ditschi/looping_louie/docs/main-board-c6.md

# Main board with ESP32-C6: module, pinout, motor driver, layer stack, routing

Status: 2026-11-11 · Describes the current state of the main board (board A, `hardware/main-board/`): **rev B**
(low-Iq LDO TPS7A2633 for 3.3 V), the design to order. Rev A with the SPX3819 LDO is kept as a fallback under the
Git tag `rev-a-spx3819`.
Current decisions: **ESP32-C6-MINI-1**, motor driver **DRV8213DSG**, **USB-C J4** on the board (flashing
only via J4), **LDO TPS7A2633** for 3.3 V, **4 layers**, machine-assembled on one side only (bottom side only pads, test points and DNP footprints).
Rejected variants (C3, DRV8833, 2 layers, earlier USB variants, SPX3819, buck TPS62162): [decision-history.md](decision-history.md).
Background: [analysis-wireless-controllers.md](analysis-wireless-controllers.md) 3b, [hardware-concept.md](hardware-concept.md),
[idea-usb-c-main-board.md](idea-usb-c-main-board.md). Firmware: [firmware-architecture.md](firmware-architecture.md).

Markers: **(verified)** = source read or recalculated against the project files · **(uncertain)** = secondary source,
estimate, or not checked in the datasheet.

## Summary

- **Module:** ESP32-C6-MINI-1, target **-H8 (8 MB)**, fallback **-N4 (4 MB)**. Both are pin- and footprint-compatible,
  so the choice is made only when ordering. Since 2026-11-06 the H8 is also in stock at JLC (620 pcs).
- **Footprint:** custom `lcsc:WIFIM-SMD_ESP32-C6-MINI-1`. Do **not** use the KiCad footprint `RF_Module:ESP32-C6-MINI-1`:
  its courtyard contains a 43 × 20 mm antenna keepout zone (breaks `antenna_keepout()`), and a
  3D model is missing.
- **Motor driver:** **DRV8213DSG** (WSON-8 2 × 2 mm) with current sensing (IPROPI), current limiting (2 A) and autosleep.
  No shunt, no nSLEEP/nFAULT, only 2 GPIOs.
- **Lever:** "lever closed" = HIGH (R3 to GND, R4 to 3V3); the lever wakes the chip with ANY_HIGH on IO3.
- **USB-C J4** with ESD (flow-through), CC resistors and power path (D2 for VBUS, Q1 for BAT_IN).
- **Supply:** VSYS 3.0–6.6 V: 1S Li-ion, USB, 3 × or 4 × AA; LDO **TPS7A2633** (U3, WSON-6): board standby approx.
  15–18 µA over the whole range, 0.47 W loss at 6.4 V / 150 mA (4 fresh alkaline cells), cut-off at 3.4–3.5 V filtered.
  No 9 V block. All supply numbers: 2.7.
- **Zigbee:** the hardware needs **nothing extra**. A coordinator alongside the device's own hotspot or alongside
  a BLE scan is **not supported (X)** by Espressif; Zigbee is only realistic on the home Wi-Fi.
- **Layers:** 4 layers (JLC04081H-3313), In1 solid GND, rules 0.15/0.15 mm, via 0.3/0.5 mm (chapter 11).
- **Routing:** complete with the own router: ERC 0, DRC 0 errors and 0 warnings, 0 unconnected, 0 GND islands,
  149 vias (rev B, 11.4).
- **Optional pads on the bottom:** player inputs J6, LED connector J7, test points, DNP footprints (11.7).

---

## 1. Module and flash

| Candidate | Dimensions (mm) | Flash | Antenna | Availability / price (2026-11-02) | Assessment |
|---|---|---|---|---|---|
| **ESP32-C6-MINI-1-N4** (C5736265) | 13.2 × 16.6 × 2.4 | 4 MB | PCB | LCSC 1,380, JLC 3,921 pcs; 4.14 / 3.63 USD (1/10) (verified) | **Fallback**, can be assembled right away |
| ESP32-C6-MINI-1-H4 (C6553337) | same | 4 MB, 105 °C | PCB | JLC 534; 4.48 / 3.84 (verified) | no advantage |
| **ESP32-C6-MINI-1-H8** (C42403058) | same | **8 MB**, 105 °C | PCB | **JLC 620 pcs** (verified, JLC parts API 2026-11-06; still 0 on 2026-11-02); LCSC 11.67 (1), 4.66 (200+) (verified). **Mouser approx. €4.70, approx. 6,000 pcs** (uncertain, search hit) | **Target**, can be assembled directly at JLC |
| ESP32-C6-MINI-1U-H4 (C20627095) | 13.2 × 12.5 | 4 MB | U.FL | JLC 3,938; 4.20 (verified) | antenna plan B only; a 1U-H8 is not listed at LCSC |

Other C6 modules do not fit the AA format or have only 4 MB with a PCB antenna; a chip-down design (C6FH8 + custom
antenna) is not worth it (decision-history.md).

**Decision:** plan for the **ESP32-C6-MINI-1-H8**. If JLC has no H8 at the time of ordering, the **N4** is assembled
without any layout change.

**Why 8 MB:** real OTA needs two app partitions; on top of that come the web UI, modes and possibly Zigbee. With 8 MB,
e.g. 2 × 3 MiB app plus approx. 1.9 MiB data fit. With 4 MB (N4), OTA gets tight; how large the Rust firmware (std on
ESP-IDF) will be has not been measured yet (uncertain). Partitioning: [firmware-architecture.md](firmware-architecture.md).

---

## 2. Module on the board

### 2.1 Footprint (verified)

Footprint `lcsc:WIFIM-SMD_ESP32-C6-MINI-1` (generated by `fetch_parts.py`): 53 pads on a 0.8 mm grid (0.8 × 0.4 mm),
pad 49 made of 9 sub-areas, courtyard 13.2 × 16.6 mm, 3D model of the C6. The pads are taken from the pad-identical
lcsc footprint of the ESP32-C3-MINI-1, because the EasyEDA footprint of the C6 is off the grid by up to 20 µm. GND pads 1, 2, 11, 14, 36–53;
3V3 = 3, EN = 8; NC = 4, 7, 21, 32–35. Antenna at the −y end of the footprint → board −x.

The KiCad footprint `RF_Module:ESP32-C6-MINI-1` is pad-identical (pad 49 shifted by max. 5 µm), but has a courtyard
of 13.5 × 16.9 mm **plus a keepout zone of 43.2 × 20.4 mm** (unusable for `antenna_keepout()`) and in KiCad 9 no
3D model.

### 2.2 Pad positions on the board

Module at x = −8.8, rotation 90°, antenna at −x (read from `louie-main.kicad_pcb`, verified):

| Module side | Pads (order) | Position | Neighbours |
|---|---|---|---|
| **right** (x = −3.9), y +4.8 → −4.8 | 12 IO0, 13 IO1, 14 GND, 15 IO6, 16 IO7, **17 IO12**, **18 IO13**, 19 IO14, 20 IO15, 21 NC, 22 IO8, 23 IO9, 24 IO18 | towards the driver and USB-C | 0402 row x = −1.9 |
| **edge +y** (y = +5.9), x −12.8 → −4.8 | 1/2 GND, 3 3V3, 4 NC, 5 IO2, 6 IO3, 7 NC, 8 EN, 9 IO4, 10 IO5, 11 GND | ISEN side | R5 (SENSE) |
| **edge −y** (y = −5.9), x −4.8 → −12.8 | 25 IO19, 26 IO20, 27 IO21, 28 IO22, 29 IO23, 30 RXD/IO17, 31 TXD/IO16, 32–35 NC | VSYS band, C1/C2, LDO | J3 on the bottom |

**All ADC pins (IO0–IO6) are in the +y half.** USB (IO12/13) sits in the middle of the right side and thus points
directly at the USB-C receptacle J4 (x ≈ 10.5–20.1, pads at y ≈ −1.6). For this, **a channel at y ≈ −0.5 … +1.2 stays free**; the
small DRV8213 (chapter 3) sits at the −y corner of the module.

### 2.3 Pinout (authoritative)

| GPIO (pad) | Net | Function | Rationale |
|---|---|---|---|
| IO0 (12) | VBAT_ADC | divider 680k/470k | ADC1_CH0; C6 measures up to 3.3 V → 6.6 V gives 2.7 V (2.7) |
| IO1 (13) | ISEN_ADC | IPROPI via RC | ADC1_CH1, +y side like the driver tap |
| IO2 (5) | INT | INT pad J2 (sensor INT1 or vibration switch) | LP GPIO → deep-sleep wake-up, no strapping |
| IO3 (6) | SENSE | lever, deep-sleep wake-up | LP GPIO, unchanged |
| IO4 (9) | VBUS_DET | VBUS divider (new) | ADC1_CH4 + LP wake-up on plug-in; strapping only SDIO edge |
| IO5 (10) | IO5 | S1 player input (J6-2) | ADC/deep-sleep wake-up |
| IO6 (15) | SDA | I²C (LIS2DH12, J2) | LP I²C (usable by the LP core) |
| IO7 (16) | SCL | I²C (J2) | LP I²C |
| IO8 (22) | IO8 | strapping, **10 k pull-up**; S4 player input (J6-5) | must be 1 during download, irrelevant for SPI boot (11.7) |
| IO9 (23) | BOOT | J3, button to GND | internal pull-up |
| IO12 (17) | USB_D− | J4 A7/B7 via ESD U5 (pin 3 → 4) | fixed in the chip |
| IO13 (18) | USB_D+ | J4 A6/B6 via ESD U5 (pin 1 → 6) | fixed in the chip |
| IO14 (19) | LED | status LED via 1 k | below the USB channel |
| IO15 (20) | IO15 | enable of LED LDO U6 (VLED on J7), R22 100 k to GND | strapping JTAG source, no effect without eFuse; no internal pull |
| IO18 (24) | MOT_IN1 | DRV8213 IN1 (LEDC PWM) | module corner bottom right, close to driver and VSYS band |
| IO19 (25) | MOT_IN2 | DRV8213 IN2 (LEDC PWM) | same |
| IO20 / IO21 (26/27) | IO20 / IO21 | S2 / S3 player inputs (J6-3/-4) | internal pull-up |
| IO22 / IO23 (28/29) | – / IO23 | IO22 free (reserve) / LED data J7-2 | keeping the power bank awake is done in firmware (idea-power-bank.md) |
| IO17 RXD (30) | RXD | console, J3-5 | |
| IO16 TXD (31) | TXD | J3, console | ROM log |

**Except for IO22 (reserve), all GPIOs are used**; IO5, IO8, IO15, IO17, IO20, IO21 and IO23 go to optional
pads and unpopulated footprints on the bottom (11.7, idea-optional-hardware.md 0b).

### 2.4 Strapping, USB, reset

- **IO8:** 10 k to 3V3 (R11). **IO9:** internal pull-up is sufficient, pad J3. **IO15:** strapping has no effect
  without eFuse, R22 (DNP) to GND. **IO4/IO5:** level during boot irrelevant (SDIO timing). **IO2** is not a
  strapping pin on the C6; R10 is the SCL pull-up (verified, analysis-wireless-controllers.md 3b.1).
- **USB:** IO12 = D−, IO13 = D+. ESD (U5) directly at J4 and **flow-through**: J4 → U5 pin 1/3 → under the
  package → pin 6/4 → module. D+/D− cross at J4 (order B7 A6 A7 B6). No stub to J1: **flashing only via
  J4**; J1-2/3 have no net.
- **ESD finding (verified, ST DS4260 Rev 5):** on the USBLC6-2SC6, pins 1/6 (I/O1) and 3/4 (I/O2) are connected internally.
  ST shows a branch to the ESD as "Unsuitable layout" (Fig. 7) and flow-through as "Optimized layout"
  (Fig. 18): D+in pin 1 → D+out pin 6, D−in pin 3 → D−out pin 4. Every stub adds L·di/dt to the
  clamping voltage (approx. 6 nH at 10 mm → +144 V at 8 kV). VBUS on pin 5, GND on pin 2; the 100 nF capacitor on VBUS
  recommended by ST is not fitted (D2 and the 47 µF buffers sit behind it). Second source UMW C2687116,
  same pinout.
- **EN:** R2 10 k / C12 1 µF. On the C6, download works automatically via USB-Serial-JTAG; BOOT remains on the
  pad as a fallback.

### 2.5 Wake-up via SENSE

**Circuit: R3 100 k OUT_A → GND, R4 10 k OUT_B → 3V3, R5 470 k SENSE → IO3.** "Lever closed" = HIGH.
R5 is only a series resistor into the high-impedance input (it does not change the levels below); 470 k limits the
current into the IO3 clamp diodes while OUT_A switches up to VSYS (6.6 V: approx. 6 µA; with 100 k it was 30 µA) and keeps
the level error from input leakage small (approx. 50 nA × 470 k ≈ 25 mV).

| State | SENSE | Wake-up |
|---|---|---|
| Lever open | 0 V (via 100 k) | – |
| Lever closed | 3.3 V × 100/110 ≈ **3.0 V** | ext1 wake-up ANY_HIGH on IO3 |
| Motor running | not meaningful, current via IPROPI | – |

Quiescent current with the lever closed approx. 30 µA. At VM = 5.5 V, OUT_B feeds approx. 0.2 mA back into the 3V3 rail;
the load absorbs this (not critical). **Special case:** if the lever stays closed when going to sleep, the firmware must
wake on LOW or check via timer (e.g. every 5 s). Check this case in the test setup ([test-hardware.md](test-hardware.md) 4.2).
Why not the inverse level: decision-history.md.

### 2.6 Antenna (finding L2 from analysis-wireless-controllers.md)

`antenna_keepout()`: rule areas "Antenna", "Antenna edge" and "Antenna end" **on all four layers**, with
copper fill and vias prohibited, **tracks allowed**. There is no GND under the antenna; the OUT_A track to BT1
runs on the bottom in the edge strip. The edge strip is at the **−y** edge (OUT_A runs from the DRV8213 at the
−y module corner to BT1 without crossing; electrically equivalent to +y, uncertain → RSSI test in both mounting orientations)
(analysis-wireless-controllers.md 2.3).

---

### 2.7 Supply

**This section is the single reference for the supply numbers** (VSYS range, 3.3 V regulator, dissipation, standby,
cut-off thresholds, divider); other documents link here instead of repeating them. Decisions: VSYS 3.0–6.6 V
(2026-11-09, F18) and **low-Iq LDO TPS7A2633 for 3.3 V (2026-11-11, rev B = the design to order)**, so that a 1S Li-ion
cell keeps a low standby current over its whole range. The buck TPS62162 tried earlier the same day did not enter
power-save mode below about 3.8 V input (finding W21). Rev A with the LDO SPX3819 in SOT-23-5 is kept as a fallback under
the Git tag `rev-a-spx3819`. Reasons and rejected options: [decision-history.md](decision-history.md); comparison and sources:
[proposal-supply-standby.md](proposal-supply-standby.md).

Sources on VSYS: protected 1S Li-ion cell on J5/J1 (3.0–4.2 V), USB via D2 (approx. 4.6 V), **3 × or 4 × AA**
(alkaline up to 6.4–6.6 V fresh, NiMH up to approx. 5.6 V) on BAT_IN. The motor voltage follows the profile of the game
(`duty = U_target / U_battery`, hardware-concept.md 4); for games with 4 × AA the motor reaches its usual voltage only
with 4 cells on BAT_IN.

Markers in this section: **(verified)** = TI SBVS290B (TPS7A26) or the JLC parts API (2026-11-11), datasheet delta
review in [wiring-review.md](wiring-review.md) 9 · **(unverified)** = estimate, the prototype decides (tests in
[test-hardware.md](test-hardware.md) 4.7).

| Item | Value | Note |
|---|---|---|
| VSYS range | **3.0–6.6 V** continuous, 7 V transient (4 fresh alkaline cells, unloaded) | 9 V block and 2S Li-ion are not supported (below) |
| 3.3 V regulator U3 | **TPS7A2633DRVR** (TI), LDO, 3.3 V fixed (±1 %), 500 mA, VIN 2.4–18 V (20 V abs. max), current limit 525–970 mA, thermal shutdown 165 °C, WSON-6 2 × 2 mm with exposed pad (DRV), LCSC C2876256 | (verified). Second source: TPS7A2601 (adjustable) C2859671 with a divider |
| C8 / C9 / C10 | C8 **4.7 µF 16 V 0402** at IN (TI: ≥ 1 µF) · C9 **22 µF 10 V 0805** at OUT (TI: 1–100 µF) · C10 100 nF 0402 at the module side; L1 and C11 not fitted | (unverified: effective C8 at 6.6 V under DC bias, no part number yet) |
| U3 pin wiring | EN (4) tied to IN (6) through the VSYS edge track, OUT (1) to C9, NC (2) and PG (3) to GND (TI: better thermal performance), GND (5) and the exposed pad (7) to GND with two tented thermal vias | (verified against SBVS290B, wiring-review.md 9) |
| Dissipation of U3, 150 mA average (hotspot mode) | (VSYS − 3.3 V) × I: **0.47 W at 6.4 V** (4 fresh alkaline cells), 0.30 W at 5.3 V (4 × AA mid-life, NiMH), 0.06–0.14 W with Li-ion | θJA 73.3 K/W (JEDEC board): about +34 / +22 / +4…+10 K; on this small board possibly more (unverified; test T14) |
| Standby, board total in deep sleep | **approx. 15–18 µA over the whole range**: U3 2 µA typ / 4.5 µA max at no load (11–15 µA at 1 mA load, so a few µA at the deep-sleep load) + ESP32-C6 about 7 µA + VBAT divider 3–6 µA + LIS2DH12 about 2 µA + leakage; 1000 mAh Li-ion: years, limited by self-discharge | (unverified; test T13 at 3.5 / 3.7 / 4.0 / 6.0 V). IQ in dropout is not specified |
| Low end (dropout) | dropout 173 / 280 mV (typ / max) at 250 mA, 355 / 590 mV at 500 mA → **about 0.27 V typ, 0.45 V max at the 380 mA radio peak**; 3V3 ≥ 3.0 V down to about VSYS 3.3–3.45 V; below that 3V3 follows VSYS | (verified table, interpolated; test T12) |
| Efficiency | 3.3 V / VSYS: about 89 % with Li-ion (as a buck), about 62 % at 5.3 V; with 4 × AA the play time drops by perhaps 10 %, because the motor draws most of the battery current | (unverified; motor current not measured, A2) |
| UVLO of U3 | 2.09 V falling / 2.15 V rising typ: below VSYS ≈ 3.3 V the output simply follows the input; the C6 brownout reset is the floor | (verified) |
| Cut-off thresholds (review R-B2) | evaluate **filtered, low-load** VSYS only (e.g. median over 2 s while duty ≤ 20 %), never during the first 300 ms of a ramp or during a stall. **Warn below 3.6 V; end the round at the next pause below 3.5 V** (3.4 V if T12 shows the typical dropout). Firmware placeholder `VSYS_MIN_MV = 3500` (`firmware/louie-fw/src/main.rs`). Brownout reset of the C6 as the last resort | final numbers from the sag measurement (test-hardware.md 4.1) and T12 |
| VBAT divider R6/R7, C13 | **680 k / 470 k** (ratio 2.447), 100 nF; 6.6 V → 2.7 V at the ADC, 3.0 V → 1.23 V; 3–6 µA | ADC check test-hardware.md 4.5 |

| Part on VSYS | Choice | Why |
|---|---|---|
| C1/C2 | **47 µF 16 V 1206** | margin and less DC-bias loss at 6.6 V |
| U6 (DNP, LED option J7) | **SPX3819M5-L (adjustable) at 3.95 V** (R23/R24 220 k / 100 k, C18 2.2 µF at the output) instead of load switch TPS22918 | enable on IO15 (R22 keeps it off) switches off the quiescent current of the LEDs; limits VLED. At 3.95 V the V5 LED types need V_IH 0.63 · 3.95 = 2.49 V, below the guaranteed ESP32 V_OH of 2.64 V (at 5.0 V they would need 3.15 V and a level shifter, for which there is no room on the bottom). With a Li-ion cell it runs in dropout (VLED ≈ VSYS − 0.3 V). Keep the brightness cap (approx. 30 %) so the LDO stays below approx. 0.3 W |
| F1 | **dropped** (VLED directly from U6) | U6 limits at approx. 0.8–0.95 A and has thermal shutdown; a 0.5 A PTC would hardly trip |
| JP1 | **dropped** | a bypass would put up to 6.6 V on the LEDs |
| U2 DRV8213, Q1 AO3401A, D2 SS34F | unchanged | VM up to 11 V; 30 V / VGS ±12 V; 40 V. **USB + 4 × AA:** Q1 only blocks while the battery is below VBUS. Above approx. 5.2 V the cells feed through its body diode even with USB plugged in; at a 2 A stall Q1 would dissipate up to approx. 1.6 W. Decision: no hardware change; use USB without AA cells, and the firmware lowers the stall limit to 0.8 A when VBUS is present and VSYS > 5.2 V (approx. 0.6 W for at most 300 ms). A real power mux is open item F28 |

**Layout of the LDO block (rev B, generated by `gen_main_pcb.preroute_ldo()`, nothing in the GUI):**
- Block at the +y edge on top: U3 (2.4, 4.97, 270°) with EN (x 1.75), GND (2.4) and IN (3.05) towards the edge at
  y 5.86 and PG, NC and OUT (x 1.75 / 2.4 / 3.05) towards the board centre at y 4.08. C8 (4.22, 5.6, 90°) right of IN,
  C9 (2.6, 2.45, 180°) right under OUT, 0.55 mm above the USB pair in the channel (y 1.13). Q1 (7.6, 4.95), R6/R7 at
  x −0.46, J2 unchanged (3.4, 4.3).
- VSYS comes from the vias of `preroute_battery_vsys()` at (5.5, 5.9) and (5.5, 6.47) over a **0.3 mm edge track at
  y 6.5** that runs west past C8 pad 1, IN and EN (0.2 mm stubs) into R6 pad 1 (VBAT divider). EN is tied to IN through
  this track. The bottom path of the battery current jogs back to x 4.67 between J2 pads 3 and 4.
- OUT goes 0.3 mm straight into C9 pad 1; C8 pad 2 runs on F.Cu into the exposed pad, GND/NC/PG stubs into the
  exposed pad. **Two** thermal vias at (2.13, 4.70) and (2.13, 5.25), centred in the gap between J2 pads 2 and 3 on the
  bottom; the board tents vias on both sides.
- 3V3 trunk to the module side, locked: via at (2.675, 3.375) next to the OUT track, 0.3 mm on In2 west under C9 to a
  via at (−1.775, 2.525), 0.3 mm on B.Cu into J2 pad 1; from there the router runs along the +y edge to module pad 3.
  Without it the router took a 40 mm detour (0.36 Ω); with it 48 mΩ (11.4). The rest of 3V3 (C10, pull-ups) is left to
  the router. The pre-routes are part of the routing baseline (11.4).

**Not supported:** 9 V block or 2S Li-ion. The TPS7A26 would accept 18 V, but at 9 V it would dissipate 0.85 W at
150 mA; the VBAT divider, the DRV8213 (11 V max), the R4 back-feed and a 2S charger would need a review, and the snap
terminals do not fit next to the board in a 9 V shell. The charger board is for 1S Li-ion only and must not be
connected to AA packs. Values marked "to check" in hardware/bom/parts.csv (U3 land pattern, C8 part number, LCSC number
of the adjustable SPX3819 for U6, availability of 47 µF 16 V) are listed in the delta review
([wiring-review.md](wiring-review.md) 9).

## 3. Motor control

**Decision: DRV8213DSGR (C22407186), GAINSEL to GND, R_IPROPI (R1) 1.24 k (1 %) to GND, followed by R8 1 k /
C14 100 nF to the ADC (IO1).** Do not put the capacitor directly on IPROPI, it would delay the current regulation.
Rationale: current sensing, current limiting and autosleep are built in; this saves a shunt, nSLEEP/nFAULT, 2 GPIOs and
approx. 30 mm² compared with a driver in HTSSOP-16. Rejected drivers (DRV8833, DRV8212, DRV8837): decision-history.md.

### 3.1 DRV8213DSG data

| Parameter | Value |
|---|---|
| VM | **1.65–11 V** (verified) |
| Rds(on) HS+LS | 240 mΩ typ. (GAINSEL = Low) (verified) |
| Current | 4 A peak, OCP approx. 4 A, RθJA 65.9 K/W (verified) |
| Current sensing | **IPROPI** 205 µA/A, ±6 % from 350 mA (verified) |
| Current limit | **ITRIP = 0.51 V / (R_IPROPI × 205 µA/A)**, R = 1.24 k → 2 A (verified) |
| Sleep | **Autosleep** after 1 ms with IN1 = IN2 = 0, < 60 nA (verified) |
| Faults | auto-retry (OCP, TSD), no pin (DSG) |
| Braking / reverse | yes: 1/1 = brake, 0/0 = coast (Hi-Z) (verified) |
| Package | WSON-8 2 × 2 mm with EP, courtyard approx. 7 mm² |
| Parts in the block | U2, R1 (R_IPROPI), C4, R8, C14 |
| GPIOs | **2** (IN1 = IO18, IN2 = IO19) |
| Price 10 pcs (JLC) | **0.93 USD** (C22407186, 3,749 pcs, Extended, 2026-11-02) |

### 3.2 Design

- Runs from 3.0 V battery up to 5.5 V USB, brakes, reverses and is high-impedance in coast/autosleep (needed for
  lever detection; whether no output pull-down is active in sleep is uncertain → check on the prototype board).
  Current limit 2 A.
- **Stall detection:** IPROPI measures while driving **and** during the brake phase. Therefore PWM as **drive/brake**:
  forward IN1 = 1, IN2 = PWM with duty cycle (1 − d). This gives 255 mV/A at the ADC. Hardware stall detection
  exists only in the RTE package; the firmware evaluates current > threshold over a time x.
- **Heat:** 1 A → 0.24 W → +16 K; 2 A continuous (stalled) → approx. 1 W → +63 K (verified, calculated with RθJA). The
  firmware must switch off a stall after ≤ 0.5 s. 2 thermal vias (0.3 mm) in the EP.
- **PWM:** LEDC at 20 kHz with approx. 11-bit resolution is sufficient; MCPWM is not needed.
- **Inputs:** IN1/IN2 have internal 200 k pull-downs in the DRV8213. **During** reset, the internal ~45 k pull-ups
  of IO18/IO19 pull both inputs HIGH → brake (no drive, no start-up possible); after reset both are 0
  (coast) (verified, C6 datasheet Tab. 2-1/2-2). Decision open (F17): leave as is, or add external 3.3 k pull-downs for
  coast during reset as well. Measurement in reset, boot and deep sleep: [test-hardware.md](test-hardware.md) 4.4.
- The DRV8213 and motor operation are only tested on the prototype board; on the breadboard there is no
  motor driver, only pre-order checks (motor current on the lab power supply, lever network, levels) and LED mode
  ([test-hardware.md](test-hardware.md) 4, 5).

---

## 4. Preparing for Zigbee

| Question | Finding | Status |
|---|---|---|
| Extra hardware? | **No.** 802.15.4 uses the same radio and the same RF path, i.e. also the module antenna | (verified) [C6 coexistence] |
| Zigbee + Wi-Fi SoftAP | Router/**Coordinator: X** (not supported), End Device: C1 | (verified) |
| Zigbee + Wi-Fi STA | Router/Coordinator: C1, End Device: Y | (verified) |
| Zigbee + BLE scan | Router/Coordinator: **X**, End Device: C1 | (verified) |
| Espressif recommendation for a gateway | Two chips with separate antennas (e.g. S3 + H2) | (verified) |
| Roles | IKEA/Aqara buttons are end devices and need a network with a **coordinator** (trust center). If Louie itself is an end device, it can only join an existing network (ZHA/Zigbee2MQTT), and the buttons are bound to it there | (uncertain, procedure) |
| Stack | `esp-zigbee-sdk`, precompiled libraries, ESP-IDF 5.5.x, C API | (verified) |
| Rust firmware | Since the firmware runs on ESP-IDF (std, esp-idf-sys), the SDK can be included as an ESP-IDF component and called via FFI | (uncertain, not tried) |
| Flash/RAM | Roughly +0.5–0.8 MB app, 50–100 KB RAM for a small coordinator. 8 MB is recommended for OTA | (uncertain) |
| Thread/Matter | same coexistence limits (Thread router + SoftAP = X). Matter over Wi-Fi needs no 802.15.4 | (verified / uncertain) |

**Assessment:** with the device's own hotspot (party mode, 8 phones), a Zigbee coordinator is **ruled out**, and
likewise alongside the BLE BTHome buttons. The only practical option would be "Louie on the home Wi-Fi (STA) + Zigbee". There, however,
it is simpler to connect the buttons via Home Assistant over Wi-Fi. **What is provided:** C6, **8 MB flash (H8)**, the
antenna keepout areas (2.6) and a good mounting location. Zigbee is **no reason for additional parts**
(operation: [idea-zigbee-operation.md](idea-zigbee-operation.md)).

---

## 5. Priority board A, optional board B

Requirement: **A works fully on its own** (second compartment = copper bridge or charger board).

### 5.1 Contents of A

| Block | Status | Remark |
|---|---|---|
| ESP32-C6-MINI-1 + C10, R2, C12 | **Must** | – |
| Motor driver DRV8213 + R1, C4, R8, C14 | **Must** | current sensing via IPROPI (chapter 3) |
| LDO TPS7A2633 (U3) + C8, C9 | **Must** | 3.3 V from VSYS 3.0–6.6 V, IQ 2 µA (2.7); second source TPS7A2601 (adjustable) with a divider |
| SENSE (R3, R4, R5) | **Must** | levels 2.5 |
| VBAT divider (R6, R7, C13) | **Must** (undervoltage, duty = U_target/U_battery) | – |
| USB-C J4, ESD U5, CC R12/R13, D2, Q1, R14/R15 | **Must** | ESD second source UMW; R14/R15 = VBUS_DET divider and gate pull-down of Q1 |
| Buffers C1, C2 (47 µF) | **Must** | – |
| Status LED D1/R9 | useful (diagnostics without a phone) | – |
| BOOT/EN/TXD/RXD | **pads only** (J3, bottom) | no button on top |
| I²C pull-ups R10/R16, IO8 pull-up R11 | on A (breakouts without pull-ups, IO8 strapping) | – |
| LIS2DH12 + C15 | top, **assembly optional** (DNP possible) | INT1 to IO2; SA0 on 3V3 → I²C address 0x19 (on GND the internal SA0 pull-up would draw approx. 150 µA); pads J2 in parallel |
| Optional pads/DNP on the bottom | J6, J7, TP1/TP2; DNP: U6 (LED LDO), R23, R24, C18, C17, R19, R20, C16, R22 | 11.7, 2.7 |

### 5.2 Interfaces (bottom side of A)

| Pad | Net | Purpose |
|---|---|---|
| J2-1…5 | 3V3, GND, SDA (IO6), SCL (IO7), INT (IO2) | sensor breakout, vibration switch (INT ↔ GND, internal pull-up) or board B |
| J3-1…5 | EN, TXD, BOOT, GND, RXD (IO17) | service (UART0 console, download) |
| J1-1…4 | BAT_IN, –, –, GND | charger board: only BAT_IN and GND; pads 2/3 have no net (flashing only via J4) |
| J5 +/− | BAT_IN, GND | protected cell directly |
| J6, J7 | player inputs S1–S4, LED connector | 11.7 |

**Without a sensor:** the pull-ups on A keep the bus in a defined state. At startup the firmware does an I²C scan (0x18/0x19)
and disables "wobble" functions if no sensor responds. INT gets a pull-down in software
(or a pull-up for a switch to GND). This has no effect if nothing is connected.

### 5.3 Board B in the second compartment

- **Feasible:** like today's charger board, B takes over the bridge. The bridge track is **in the motor circuit**
  (PWM potential) and must remain **galvanically isolated** on B from GND/3V3 of the B electronics. The cable to A
  (5 wires for the sensor, 6 with charging circuit: BAT_IN, GND, 3V3, SDA, SCL, INT) runs across the partition as it does today.
  I²C over approx. 10–15 cm at 100 kHz is not critical (uncertain).
- **Old Louie (1 × C):** B sits in the C sleeve above A (hardware-concept.md 6: 2 boards with approx. 10 mm spacing
  fit). The bridge stays unused.
- **Is a dedicated B worth it?** For the sensor alone **no**: a ready-made breakout (LIS3DH/LIS2DH12/MPU6050, approx.
  €1–5, often approx. 16–20 mm wide, uncertain) fits in the base or the C sleeve, but probably not in the AA compartment. Even
  simpler is a **spring switch** (e.g. SW-18010P) between INT and GND: it wakes on shaking, without any I²C.
  **A board B is only worth it as "B charger + sensor"**, i.e. as a further development of today's charger board v0.2.

### 5.4 Recommendation

**A** = C6 + DRV8213 + LDO + SENSE + VBAT + IPROPI + USB-C stage + LED, everything else as pads. **Manufacture only A
first**, with the copper bridge or the charger board in the second compartment. Sensor on top assembly optional, otherwise breakout
or spring switch on J2. The **charger board v0.1** remains usable on J1 (BAT_IN). A board B only later, and
then only as v0.2 "charger + sensor".

---

## 6. Mechanics: USB-C vs. AA envelope

Calculated from the 3D export (`just model`, `just hull` → `hull_check.py`, vertices of
`build/main-board/3d/louie-main.stl`; top of the board 0.5 mm above the cell axis):

| Parameter | Value |
|---|---|
| J4 front edge | y = +6.10 mm (board edge there 6.75 in the recess in front of J4, otherwise 7.05) |
| J4 top edge | z = +3.75 mm above the cell axis |
| largest radius of all components | **6.94 mm** (J4, upper front edge) with AA radius 7.25 → **approx. 0.3 mm clearance** |
| largest radius overall (since 14.1 mm width) | **7.06 mm** (board edge top, x ±21.9) → 0.19 mm clearance |
| components under the end caps (x > 22.2) | none |
| bottom side | largest \|y\| 4.80 mm (pocket 5.2 mm), component height on the bottom see 11.7 |

`sleeve.scad`: cable window on **+y** (`cable_side = 1`, `cable_x = 14.5`, `cable_l = 9`) for J1 and J5 under the
receptacle, board dummy at the C6 state, view `part = "collision"`. The shell lies below the board, the
receptacle on top is freely accessible; a separate receptacle window is not needed. **Open:** because of the cable window,
the edge ledge (+y) is missing under J4 as a support; plugging forces go into the solder tabs (0.8 mm board, idea-usb-c-main-board.md).
Remedy: shorter and deeper window, or a support ledge between J1 and J5 (test on the printed part).

## 7. Open items and checks before ordering

1. Checks before ordering ([test-hardware.md](test-hardware.md) 4): motor current, lever network, wake-up with
   ANY_HIGH on IO3, strapping, levels of IO18/IO19 (F17), ADC divider.
2. DRV8213 on the Louie motor: current, heating when stalled, lever detection in autosleep (outputs Hi-Z).
3. Check H8 stock at JLC at the time of ordering (2026-11-06: 620 pcs), otherwise N4.
4. ~~Finish routing~~ done: rev B routed completely, ERC 0, DRC 0, 0 unconnected (11.4). Delta review of the LDO block:
   [wiring-review.md](wiring-review.md) 9.
5. Load the Gerbers (`just fab`) into the JLC calculator (website and JLCONE), select stack-up JLC04081H-3313, read off price and
   manufacturing time for 0.8 mm (cost-estimate.md 5.7).
6. Look at the layout in the KiCad GUI (router detours, via count), smooth individual tracks if needed – after that the GUI state is authoritative.
7. RSSI test (antenna edge strip −y, both mounting orientations).
8. Sleeve: support under J4 (chapter 6), test print.
9. Cross-check other manufacturers (Aisler, PCBWay) before ordering there.

Part costs (10 pcs, LCSC/JLC 2026-11-02): C6-N4 3.60 USD, H8 approx. 5.4 USD (Mouser €4.70, uncertain), DRV8213
0.93 USD, USB-C stage approx. 0.37 USD (J4 0.19, U5 0.05, D2 0.04, Q1 0.08, 3 R). Total cost: [cost-estimate.md](cost-estimate.md).

*Chapters 8–10 have been dropped (history in [decision-history.md](decision-history.md)); number 11 is kept because of
references from scripts and other documents.*

---

## 11. 4 layers: stack-up, rules, generator, routing

**Decision 2026-11-03: 4 layers** (reasons and the rejected 2-layer variant: decision-history.md).
The board is in `hardware/main-board/louie-main.kicad_pcb` (project `louie-main.kicad_pro`, rule file
`louie-main.kicad_dru`, routing result `routing.json`); `just pcb`, `just route`, `just erc`, `just drc`,
`just images`, `just model`, `just render`, `just fab` work on it without parameters. Everything is generated by the
scripts, nothing in the GUI.

### 11.1 Layer stack-up

**JLC standard stack-up JLC04081H-3313** (0.8 mm, 4 layers, outer 1 oz, inner 0.5 oz) **(uncertain)**: values from
a stack-up file generated from the template of the JLC impedance calculator (Hive-RSI-Lab/hive-hwde
PR 533, 2026-11-01); the JLC calculator itself only delivers the values via JavaScript and was not read.
The sum of 0.7992 mm matches the nominal thickness. Confirm in the JLC order form ("Layer stackup")
before ordering.

| Layer | Material | Thickness | εr | Use (chosen variant A) |
|---|---|---:|---:|---|
| L1 F.Cu | copper 1 oz (incl. plating) | 0.035 mm | – | components, short signals, GND fill |
| Prepreg | 3313 (1 ×) | 0.0994 mm | 4.1 | |
| L2 In1.Cu | copper 0.5 oz | 0.0152 mm | – | **solid GND**, no tracks (keepout area "GND layer") |
| Core | FR4 | 0.5 mm | 4.48 | |
| L3 In2.Cu | copper 0.5 oz | 0.0152 mm | – | signals (crossings, buses), GND fill in between |
| Prepreg | 3313 (1 ×) | 0.0994 mm | 4.1 | |
| L4 B.Cu | copper 1 oz | 0.035 mm | – | solder pads (J1/J2/J3/J5/BT), motor outputs, signals, GND fill |

The stack-up is stored as `(stackup …)` in the `.kicad_pcb` (`STACKUP`, `write_stackup()` in `gen_main_pcb.py`).

**Layer assignment (variant A):** Sig / **GND** / Sig+GND / Sig+GND, i.e. 3 signal layers. Other assignments
(3V3 plane on L3, GND twice, GND on the outside) were rejected (decision-history.md).

- **Routability:** crossings and long buses run on L3; L4 does not have to be a ground plane. A 3V3 plane on L3
  only helps 3V3 (10 pads) and takes away the layer for crossings; in a trial run with Freerouting it was not better.
- **RF ground:** L2 is 0.1 mm below the components; module, DRV8213 and USB have a continuous reference plane.
  Under the antenna there is no copper **on any of the four layers**: the keepout areas "Antenna", "Antenna edge" and
  "Antenna end" from `antenna_keepout()` apply to `AllCuMask` and are stored in the file with
  `(layers "F.Cu" "B.Cu" "In1.Cu" "In2.Cu")` (verified); the GND fills of all layers end before the antenna.
- **USB:** Full Speed (12 Mbit/s) needs no impedance control. 0.15 mm tracks over GND at 0.1 mm spacing
  give roughly 50 Ω single-ended (uncertain, rule of thumb); the pair is pre-routed (ESD flow-through, 2.4).
- **Motor current:** the 0.4/0.5 mm main paths (OUT_A/OUT_B, VSYS, VBUS, BAT_IN) are pre-routed; the return currents
  flow through the solid L2.

### 11.2 Design rules (4 layers)

Source: [JLCPCB PCB Capabilities](https://jlcpcb.com/capabilities/pcb-capabilities), retrieved 2026-11-03 (verified),
and cost-estimate.md 5.4.

| Parameter | JLCPCB 4 layers | Project rule (`RULES`, `louie-main.kicad_dru`) | Margin |
|---|---|---|---|
| Track / clearance | 0.09 / 0.09 mm (outer 1 oz, inner 0.5 oz) | **0.15 / 0.15 mm**, default track 0.2 mm | +67 % |
| Via drill / Ø | min. 0.15 / 0.25 mm; surcharge below 0.3 mm drill (or 0.2/0.25 with Ø < 0.45) | **0.3 / 0.5 mm**, annular ring 0.1 mm | no surcharge, annular ring 2 × minimum |
| Via-in-pad | only with surcharge (POFV), free only from 6 layers | **not used** (router blocks vias in pads) | – |
| Via drill – copper | 0.2 mm (inner) | 0.25 mm (board rule) | +25 % |
| Component hole – track | 0.28 mm (recomm. 0.35) | 0.28 mm outer | = minimum |
| Component hole – inner copper | 0.3 mm | 0.3 mm (custom DRC rule) | = minimum |
| Hole-to-hole spacing | 0.2 mm | 0.25 mm | +25 % |
| Copper – routed edge | 0.2 mm | 0.3 mm (+ keepout strip "Edge") | +50 % |
| Power tracks | – | pre-routed 0.4/0.5 mm on the outer layers (since 2026-11-04 also Q1 → VM, 11.7), 3V3 0.25 mm, VSYS branches 0.3–0.4 mm (never narrower) | – |

**Via 0.3/0.5 instead of 0.3/0.6 mm:** with a 0.6 mm diameter, clearly more connections remained unrouted in the trial
routing (run 1: 13 instead of 5); the drill stays 0.3 mm, there is no surcharge, and a 0.1 mm annular ring is
twice the JLC minimum (0.05 mm at 0.15/0.25). The vias of the pre-routes are also 0.5 mm.

### 11.3 Implementation in the generator

| File | Task |
|---|---|
| `gen_main_pcb.py` | generates the 4-layer board in `hardware/main-board/`: `RULES`, `DRU` (rule file), `STACKUP`, outline from `board_outline.py`, In1 = GND plane + keepout area "GND layer" (no tracks), In2 = GND fill, pre-routes (USB, VBUS, BAT_IN, motor, VSYS), `PLACEMENT_OVERRIDES` (among others **R15 rotated by 180°**, otherwise its GND pad is enclosed between VBUS tracks and the USB pair) |
| `placement.py` | placement (assembled on one side, parts on the bottom only pads/DNP) |
| `route_fix.py` | custom maze router: A* over F.Cu/In2.Cu/B.Cu on a 0.05 mm grid, vias 0.3/0.5 only where they fit on all layers, escape lanes in front of the module pads, rip-up and reroute with history costs, then GND islands via a via to In1, restart with priority for unrouted nets; deterministic |
| `route.py`, `route_gate.py` | `main-board` (4 layers, `ROUTER=own` default with 6 cost variants, or `ROUTER=freerouting` + post-routing) and `charger-board` (2 layers, Freerouting); keep-best gate against `routing.json` |
| `stitch.py` | stitching for 4 layers (opposite layer = In1, clearance check on all layers) |
| `justfile` | `pcb`, `plot` without parameters; `main-board` = create + route + ERC + DRC; `images` also generates the inner layers |

**Footprints:** U1 `lcsc:WIFIM-SMD_ESP32-C6-MINI-1` (2.1); U2 `Package_SON:WSON-8-1EP_2x2mm_P0.5mm_EP0.9x1.6mm`
(pad-identical to Texas DSG0008A, with 3D model); U3 TPS7A2633 `Package_SON:WSON-6-1EP_2x2mm_P0.65mm_EP1x1.6mm`
(DRV0006A, pads slightly different from TI's example, wiring-review.md 9); J4 `louie:USB_C_Receptacle_HRO_TYPE-C-31-M-12` (from `fetch_parts.py`,
3D model of the LCSC part, no silkscreen over the edge); D2 EasyEDA SMAF with corrected courtyard.
GND pads are fully connected to the fills (no thermal reliefs; otherwise small pads only got one spoke).

**Images** (`just images`, `docs/images/`): `board-*.png`, `copper-top.png` = L1, `copper-l2-gnd.png` = L2,
`copper-l3-signal.png` = L3, `copper-bottom.png` = L4, `placement.png`.

Commands: `just pcb && just route && just erc && just drc` or simply `just main-board`; images `just images`,
3D `just model`. `just route` takes 20–60 min depending on the variant (3 variants in parallel, custom router in Python).

### 11.4 Routing result

**Current state: rev B (LDO TPS7A2633, 2026-11-11), routed completely with the own router.** `just route main-board
runs=8` (4 attempts in parallel, about 11 min): **seven of eight attempts complete** (0 open, 0 DRC errors), the gate
took attempt 4 (via cost 30, F 1.6, B 1.3). Baseline: `hardware/main-board/routing.json`, fingerprint **be7c6f9fbd**.
No router change and no manual clean-up were needed.

The first run on the LDO block (without the 3V3 trunk) was also complete in six of eight attempts, but the router had
connected the module side of +3V3 through a detour of about 40 mm around the USB end: about 0.36 Ω from U3 OUT to module
pad 3, 137 mV at the 380 mA radio peak. Since then `preroute_ldo()` lays a locked 3V3 trunk (via, 0.3 mm on In2, via,
B.Cu into J2 pad 1, 2.7). Result: **48 mΩ, about 18 mV at 380 mA** (own graph calculation over the copper; the buck trial had
52 mΩ). Since then the routing score contains this path with a hard limit of 50 mV at 380 mA (routing-score.md 3); its
model gives 38 mΩ / 14.6 mV for the current board and rejects the detour state.

| Check | **Rev B** (LDO, design to order) | Buck trial (same day, superseded) | Rev A (SPX3819, tag `rev-a-spx3819`) |
|---|---|---|---|
| ERC (`just erc`) | 0 errors, 0 warnings | 0 | 0 |
| DRC (`just drc`) | **0 errors, 0 warnings, 0 unconnected**, schematic parity 0 | 0 / 0 / 0 | 0 / 0 / 0 |
| GND islands | 0 | 0 | 0 |
| Vias | **149** (79 signal, 70 GND) | 162 | 157 |
| Track length | **796 mm** (F.Cu 273, In2.Cu 255, B.Cu 268; **In1.Cu 0**, GND layer free of tracks) | 805 mm | 808 mm |
| Routing score S (lower is better) | 111.2 (best of 8 attempts) | 110.3 (best of 8) | 98.0 (best of a 120-attempt long run) |
| Complete attempts | 7 of 8 | 5 of 8 | 19 of 120 |
| 3V3 from the regulator to module pad 3 | 48 mΩ (score model: 38 mΩ, 14.6 mV) | 52 mΩ | not checked |
| Antenna keepout, power widths | 0 intrusions, 0 width violations | 0 / 0 | 0 / 0 |
| Envelope | largest radius 6.94 mm (J4) < 7.25 mm, chapter 6; U3 (0.8 mm) and C9 (0805) are lower than the module | – | – |

Under the antenna there is no copper on any of the four layers except the permitted OUT_A track to BT1 on B.Cu in the
edge strip (keepout areas "Antenna", "Antenna edge", "Antenna end", 11.1).

**Why a custom router?** Freerouting 2.5.0 (as with 2 layers) got stuck on 4 layers at **10–18 unrouted
signal connections** (several settings: In1 as a plane with/without GND connection, In2 as a 3V3 plane, fanout on/off).
In addition, two quirks: without a plane, Freerouting treats a "power" layer as a signal layer and put tracks on In1;
a keepout for tracks only on In1 (`wire_keepout`) also prevents all vias in 2.5.0. The existing
pre-routes (USB, VBUS, motor) stayed unchanged; `route_fix.py` routes all remaining signals, the GND connection
and the islands. `ROUTER=freerouting just route` is kept as an alternative (Freerouting + post-routing).

**Spread of the router (design state 2026-11-03, before the bottom pads; same starting board, different cost variants
from `ROUTER_VARIANTS`):**

| Run | Variant (via cost / F / B) | unconnected (DRC, after stitching) | other DRC messages |
|---|---|---:|---|
| A-1 | 1 (30 / 1.3 / 1.15) | 1 (GND island) | 1 dangling track (0.14 mm) |
| A-2 | 2 (20 / 1.3 / 1.15) | 2 (GND islands) | 1 clearance VSYS–GND (U3), 1 dangling track |
| **A-3** | **3 (40 / 1.3 / 1.15)** | **0** | **none** → adopted |
| B-3 | 3 (repeat) | 4 (GND islands) | 1 dangling track |
| B-4 | 4 (30 / 1.6 / 1.3) | **0** | **none** (second clean state, `build/main-board/keep/variant4-0-open.kicad_pcb`, not checked in) |
| B-5 | 5 (25 / 1.1 / 1.0) | 5 (GND islands) | 1 dangling track |
| B-6 | 6 (35 / 1.5 / 1.1) | 1 (GND island) | 1 hole-to-hole spacing (two ISEN_ADC vias), 2 dangling tracks |

**Spread over 7 runs: 0–5 unconnected (median 1), 2 of 7 runs completely clean (DRC 0, 0 unconnected).**
All unconnected items are GND fill islands, no signal. The remaining messages are residual errors of the custom
router (short dangling track pieces after rip-up, one clearance or hole-to-hole error each); they occur only in the
runs that were not adopted. `route.py` picks the best run of a call; it only becomes official if it is better than the state in
`hardware/main-board/routing.json` (keep-best gate, `docs/development.md`).

The same costs do not give a bit-identical result (A-3 vs. B-3): the order of the unconnected items comes from the
KiCad DRC and depends on the random UUIDs of newly built tracks. In all runs **all signal connections are
routed**; only GND fill islands around 0402 parts next to the module remain unconnected (C13/C14 with module pads 11/52, C4/R3, C12),
for whose via there is hardly any room in the dense row. Run time per run 25–60 min (3–4 runs in parallel).

**Known weaknesses (look at them in the GUI before ordering):** the router lays tracks on a 0.05 mm grid with 45° bends;
some paths make detours via vias. Electrically not critical (no fast signals
except USB FS, which is pre-routed), visually not "hand-routed".

*11.5 and 11.6 (comparison of 2/4 layers, decision) have been dropped: decision-history.md. Cost of 4 layers:
approx. +€3 / +€6 / +€10 per order for 5 / 10 / 30 pcs, manufacturing +1–3 working days (cost-estimate.md 5.6,
uncertain). Order preparation: chapter 7.*

### 11.7 Optional pads on the bottom and battery motor path (status 2026-11-04)

Implementation of idea-optional-hardware.md 0/0b (datasheet check there in 0b.6, deviations in decision-history.md) and finding 8.1 from
routing-score.md. **Decision 2026-11-05:** no RC footprints on S2–S4 (J6 is pads only; internal pull-ups and
1 kΩ in the cable are sufficient) and no hardware load pulse (Q2/R17/R18 dropped, IO22 stays free; keeping the power bank awake is done in
firmware, idea-power-bank.md). Everything from the generators, nothing in the GUI. **Top unchanged**; bottom only pads, test points and
**unpopulated footprints (DNP)**. DNP is set in the schematic (`dnp`) and on the footprint; `just fab` omits these parts from the
placement list and the BOM (`--exclude-dnp`), one-sided assembly is preserved.

**Pads and footprints on the bottom** (coordinates: board centre, view from the top; all parts in the pocket |y| ≤ 5.2 mm,
tallest part U6 1.45 mm):

| Ref | Assignment | Position | Assembly |
|---|---|---|---|
| J3 | 1 EN · 2 TXD · 3 BOOT · 4 GND · **5 RXD (IO17)** | x −13.63 … −3.47, y −3.35 (previously −3.25) | pads |
| J6 "Players" | 1 3V3 · 2 S1 IO5 · 3 S2 IO20 · 4 S3 IO21 · 5 S4 IO8 · 6 GND, pitch **2.0 mm** | x −3.63 … −13.63, y +3.2 (under the module towards edge +y) | pads |
| R19 / R20 / C16 | IO5 → 3V3 10 k / → GND 1 M / → GND 10 n (N4) | middle row of the module pad, x −11.9 / −9.8 / −7.8, y 0 | DNP |
| J7 "LED" | 1 VLED · 2 IO23 · 3 GND | x +10.74 … +5.66, y −4.2 (side −y, away from the driver) | pads |
| U6 | LDO SPX3819 adjustable (3.95 V) VSYS → VLED, EN = IO15 (2.7) | (2.2; 1.2), rotated 90°, OUT/ADJ towards −y | DNP |
| C18, R23, R24 | output capacitor 2.2 µF and feedback divider 220 k / 100 k of U6 | C18/R23 at (6.15; −2.65/−1.57) between the VSYS vias and the VBUS track, R24 above U6 | DNP |
| C17, R22 | 10 µF on VLED; 100 k IO15 → GND | (14.7; −2.05) under USB-C / (−0.15; 2.0) next to the EN pin of U6 | DNP |
| TP1, TP2 | VSYS, VBUS (Ø 1.0 mm); TP3/TP4 dropped (measure ISEN at R1, SENSE at R5) | (8.4; 2.4), (12.2; −1.4) | pads |
| J2 | as before | **y +4.3** (previously +5.3; pads now in the pocket) | pads |

Assembly variants for J7: NeoPixel chain (fit U6 + R23 + R24 + C18 + C17), single
LED or button on J7-2/J7-3 without parts. **Without U6, J7-1 is unpowered.**

**Battery motor path (finding routing-score.md 8.1):** Q1 pin 2 (VSYS) is now pre-routed: top 0.5 mm to two
vias at edge +y, bottom 0.5 mm between J2 pads 3/4 southwards, two vias to the right of C2 pin 1, on top into its pad
(`preroute_battery_vsys()`). Outer layers only; IPC-2221 requires 0.35 mm on the outside for 1.5 A at 20 K. Measured on the
unrouted board: path Q1 → VM 13.6 mm, 2 vias, 15.5 mΩ, **31.0 mV at 2 A** (previously 56.2 mV, 0.2 mm, partly In2),
no violation. `route_fix.py` never routes VSYS below 0.3 mm (except to R6 and TP1), VLED/VLED_SW with 0.4 mm.

**Routing status: complete since 2026-11-10, current result in 11.4.** The rounds below are the path there.

| Attempt | Change beforehand | Result |
|---|---|---|
| A | first version (J6 at y = 0) | VBAT_ADC (R6) without a path: J6 pad 1 was under R6, where the via belongs; aborted |
| B | J6 to y −1.3, J3 −3.35 | after the 1st pass 37–44 unconnected; limit of 300 steps reached |
| C | pre-routes VLED_SW, VBAT via; 800 steps | TP4 (SENSE) unreachable between F1/C17/USB; aborted |
| D | TP4, R22 moved | 1st pass up to 50 unconnected; VBUS gate branch on In2 formed two walls with the VSYS track on the bottom |
| E | VBUS branch back on B.Cu, TP3/TP4 to the right end | ISEN_ADC via next to J2 blocked by C16; aborted |
| F | RC row lower, QOD narrow | after approx. 550 steps 45–51 unconnected (all four attempts), 1st pass 40 unconnected; aborted after 1 h |

After that, QOD of U6 was also left open (one connection fewer); not routed again.

**Continuation 2026-11-05/06 (after the decision, log per round):**

| Round | Change beforehand | Result |
|---|---|---|
| G | RC footprints S2–S4 and load pulse removed; R19/R20/C16 under the module towards edge +y (y 3.6) | route_fix, 4 attempts: after the 1st pass 3 / 3 / 6 / 25 unconnected; remaining were LED (U1.19–R9), SENSE (R5–U1.6, R5–TP4), ISEN_ADC (R8), EN, VSYS stub at R6. Aborted by end of session, nothing adopted |
| H | J6 on a 2.0 mm pitch (`SolderPads_1x06_P2.00mm`) at y = 0, x −13.63 … −3.63: J6 pad 1/2 at y −1.3 were exactly under the 0402 row and the right module pads, where the router needs its vias. GND vias in module pad 7 → 5 | `ROUTER=freerouting`, 3 attempts (30 min): Freerouting reports 0 unconnected, after import and route_fix 19 remain unconnected, 5 DRC errors (best attempt 2). Because the design changed, the gate adopted it as the new baseline (S 170.2, hard 21) |
| (I) | – | accidentally started from the routed board (without `just pcb`); route_fix only added to it, 16 unconnected, DRC 5; the gate adopted this as a smaller violation (hard 18 instead of 21, S 161.5) |
| J | `just pcb` (same design) | custom router, 4 attempts, aborted after 40 min: J6 at y = 0 is under the right module pads 17–19, whose inward escape paths need vias; LED (U1.19–R9) and ISEN_ADC without a path |
| K | J6 to y +3.2 (under the module towards edge +y, pads 2.5 … 3.9), R19/R20/C16 and R22 into the middle row of the module pad (y 0) | custom router, 4 attempts; after 47 min a worker process died (memory), the call aborted without the gate. Best intermediate state (attempt 3, 1st pass 5 unconnected signals) post-processed by hand like `route.py` (stitching, GND islands) and passed through the gate with `route_gate.py check --apply`: **adopted**, 14 unconnected (of which 9 GND fill pieces), 2 DRC errors, hard 16, S 169.8 |

**State after round K (superseded by round L, see below):** the official board was round K, `routing.json` matches it
(fingerprint 86f5c8e336). Hard constraints: `unconnected` 14, `drc_errors` 2; `antenna_intrusions` 0,
`power_width_violations` 0 (Q1 → VM 0.5 mm outer). Unconnected:
- Signals: +3V3 at R16, EN (U1.8 and J3.1 to the EN track), ISEN (R1–U2.8), ISEN_ADC (R8); plus 9 GND fill pieces without
  a via (C8/C10–C14, C16, D1, R15, R20, U4, U6).
- DRC: 2 × hole-to-hole spacing between a SENSE via (path to TP4 at the right end) and the USB-C tab S1.

**Proposal (decision by the project owner):**
1. Remove TP3/TP4 (ISEN at R1, SENSE at R5 can be measured from the top) – eliminates the two DRC errors and two long
   paths across the board.
2. Move the J7 group away from the driver: J7 sits at y −3.3 exactly under U2/R1/R8, where ISEN/ISEN_ADC and the GND islands need their
   vias. Either drop U6/JP1/F1/C17 entirely (J7 pads only: IO23, GND, VSYS via solder jumper) or move J7 with its group
   under USB-C −y (free since Q2/R18 were dropped; check space).
3. Then one round with 4 attempts; only if something is still unconnected after that, extend `route_fix.py` (start at
   pre-route vias on all layers, vias under component bodies) – the VBAT_ADC stub shows the problem.

| Round | Change beforehand | Result |
|---|---|---|
| L | Decision 2026-11-06: TP3/TP4 removed; J7 to (8.2; −4.2) on side −y, C17 under USB-C. The whole group does not fit under USB-C (U6 alone does, but then there is no room left for F1/JP1; search with clearance check): U6, F1, R22 into the centre above y −0.3, JP1 as 0603 pads next to the VSYS vias; the area under driver/R1/R8 and to the right of the module stays free. VLED pre-route dropped. Envelope: radius 6.94 mm, bottom \|y\| ≤ 4.9 (pads), height U6 1.45 mm (model 1.64) | custom router, 4 attempts from `just pcb` (2 h): after stitching 12 / 29 / 12 / 19 unconnected; attempt 3 **adopted** by the gate (design changed): 12 unconnected = 3 signals + 9 GND fill pieces, **0 DRC errors**, hard 12, S 166.0. Attempt 1 had S 143.3, but 2 DRC errors |

**Status 2026-11-06 after round L:** official board = round L, attempt 3; `routing.json` matches (fingerprint
7e41ca5b46). ERC 0, schematic parity 0, DRC errors 0 (warnings: hole-to-hole spacing of two VLED vias, one dangling
VBAT_ADC via), `antenna_intrusions` 0, `power_width_violations` 0. Unconnected (`unconnected` 12):
- Signals: ISEN_ADC at R8 (to the pre-routed track), LED (U1.19–R9), VLED_SW at F1.
- 9 GND fill pieces without a via (F.Cu/B.Cu).

**Proposal for `route_fix.py` (approved and implemented on 2026-11-06, see round M):** the three unconnected signals are all at
a track end or pad that the router only approaches on its own layer (ISEN_ADC, VLED_SW) or in the dense
0402 row to the right of the module (LED). Extension:
1. Allow start and target at pre-route vias and at track ends on all layers (via at the end of a pre-route = connection
   on F.Cu, In2 and B.Cu); this also affects the VBAT_ADC via that is left dangling today.
2. Allow vias under component bodies on the bottom (between the pads, e.g. under U6, C17) if the clearance to the pads
   is sufficient.
3. GND islands: also search for a via in the fill next to the pad instead of only at the pad (finer stitching grid).
Then one round with 4 attempts.

**Implementation in `route_fix.py`** (options at the top of the file, each can be switched off):
- `ENDPOINT_VIAS = True`: a via of the same net at the connection point (track end or pad, including locked pre-route vias)
  counts as start/target on F.Cu, In2 and B.Cu.
- `VIA_UNDER_BODIES = "bottom"`: vias between the pads under component bodies are allowed (this was already the case, now
  named and checked); `"none"` blocks the courtyards. Via-in-pad and antenna keepout areas stay blocked.
- `ISLAND_AREA_SEARCH = True`: for a GND island without a via, the router searches for the via site in the entire fill area
  of the island if it is not possible from the pad.
- Quick check `just route-check` (`test_route_fix.py`, approx. 30 s) on the board from round L:
  - The VBAT_ADC stub now starts on all three layers (previously only F.Cu).
  - 85 permissible via sites under U6, none in foreign SMD pads or in the antenna keepout area.
  - Unconnected signals: without rip-up 0 of 3, with rip-up 2 of 3 (ISEN_ADC, LED); VLED_SW at F1 remained without a path.
    Cause: F1 was enclosed between the VSYS and VBUS tracks on the bottom.
  - GND islands: without area search 1 of 10 connected, with area search 2 of 10.
- Therefore F1 to (6.2; −1.5), VLED_SW north to JP1 (now (6.2; 1.8)), VLED south to J7. R22 back
  to (−13.7; 0). Trial on the unrouted board: VLED_SW, VLED, VSYS, IO15 routed on their own, 0 unconnected.

| Round | Change beforehand | Result |
|---|---|---|
| M (13.5 mm) | router extensions, F1/JP1/R22 as above, `just pcb` | 4 attempts from 20:49; after the 1st pass 12 / ? / **1** / 14 unconnected. Aborted after 50 min because the board was to be made wider before round M; intermediate state of attempt 3 in `build/main-board/keep/roundM-13.5mm-attempt3-pass1.kicad_pcb` |
| M (14.1 mm) | board 14.1 mm wide (11.8), otherwise as above, `just pcb` | custom router, 4 attempts (21:42–23:30): after the 1st pass 2 / 9 / 1 / 10, after the 2nd pass 17 / 1 / 8 / 4 unconnected signals. The gate took attempt 3 (design changed): **1 unconnected signal** (ISEN_ADC at R8), 11 GND fill pieces without a via, 2 DRC errors (hole-to-hole spacing of a router via VBUS to the J4 tab S1), hard 14, S 162.9. `just route-check` on this state: the 11 GND islands can all be connected with area search **and** rip-up (none without rip-up) |
| M+ | post-processing `route_finish.py` (new): route_fix on the routed board, all router tracks can be ripped up (`rip_tracks`), GND islands also to already connected fill (`ISLAND_AREA_SEARCH`), then stitching like `route.py`, finally `fragment_vias()` (via into every fill piece without a connection) | 18 min, 206 steps; the best intermediate state was the starting state (1 unconnected signal). `fragment_vias()` found no via site in any of the 11 fill pieces: under them there are tracks or pads of other nets on In2/B.Cu. Not passed to the gate, the official board remains round M |

Main reason: under the module and to the right of it (x −14 … 0), previously there were only J3 and the vias through which the router takes the
module pads down. Now J6, R17, eight RC footprints and the J2 vicinity are there; in addition, the
0.5 mm VSYS track divides the bottom side from north to south. Proposals (decision by the project owner):
1. Fewer footprints on the bottom in the module area: omit pull-ups R23/R24 (internal 45 k are sufficient according to 0b.2),
   RC footprints only for IO5 (N4), C18–C20 dropped or moved to the cable end.
2. Improve `route_fix.py`: use via sites under component bodies (e.g. R17), allow track ends at pre-route vias on all
   layers as start (the VBAT_ADC stub ends at a via, the router only starts on F.Cu).
3. Try Freerouting as a pre-stage (`ROUTER=freerouting`) for this version.
4. Parts on the bottom in a different location in a second version (e.g. R17/Q2 as 2 × 1206 next to USB-C; the load pulse has since been dropped, see decision-history.md).

**Envelope (`just model`, `just hull`, all bottom parts with 3D model):** largest radius 6.94 mm (J4, unchanged)
< 7.25 mm; bottom largest |y| 4.80 mm (pocket 5.2), end caps clear. Largest component height on the bottom 1.64 mm according to the generic
KiCad model of U6 (then the TPS22918, at most 1.45 mm per TI; U6 is now the SPX3819 in SOT-23-5, height to check with `just hull`). The pocket is 2.0 mm deep,
so 0.55 mm (model: 0.36 mm) of clearance remains instead of the planned 0.5 mm; with the model, `just hull` reports
that the 1.5 mm limit is exceeded.

**DNP in the manufacturing data (verified):** placement list with `--exclude-dnp` only 36 parts, all on top; BOM
without U6, F1, C17, R22, Q2, R17, R18, R19/R20/R23/R24, C16/C18–C20; `…-bom-all.csv` lists them as
"Do not populate".

**Further generator changes:**
- Net classes: `setup_rules()` deletes all patterns and classes from the `.kicad_pro` and sets them anew (Power: VSYS,
  BAT_IN, VBUS_J4, OUT_A, OUT_B, VLED, VLED_SW; Supply: +3V3, GND). The old entries (MOT_A/MOT_B, ISEN in Power,
  GND and VSYS duplicated) are gone.
- The OUT_A stub to R3/R5 runs on In2 instead of B.Cu (room for J7). The VBUS branch to the gate of Q1 stays on the bottom,
  now at x = 7.25 passing to the right of JP1, vias at (8.3; −2.5) and (7.5; 3.2). On In2 it formed two parallel walls with the VSYS track
  on the bottom, and the router could hardly get from west to east any more (37–50 unconnected).
- GND vias in the module pad: where there is a pad on the bottom (J6, R17), the via moves up to 1 mm to the side or is dropped: 7 instead of 9.
- Additional pre-routes for the router: VLED_SW (U6 pin 6 → JP1 and F1) with 0.4 mm on B.Cu passing under the VSYS vias
  (`preroute_vled()`), VBAT_ADC via to the left of R6 (`preroute_vbat_escape()`). `route_fix.py` may take 800 instead of 300 steps
  per pass (`MAX_ROUNDS`); with the parts on the bottom, 300 were no longer enough (37–44 unconnected).
- On the bottom to the right of the module (x −5 … 0), the router needs room for the vias of the module pads. TP3/TP4 and R22
  were there at first (or TP4 enclosed between F1, C17 and the USB tracks) and blocked it; now TP3/TP4
  at the right end, R22 to the left of R17, the RC row to the right of R17 at y 1.6 and C16 lower, so that next to J2 pad 1
  the ISEN_ADC via (C14) has room again.
- First attempt with J6 at y = 0: J6 pad 1 was under R6 (top) exactly where VBAT_ADC needs its via; the router
  found no path for R6–R7 any more. Therefore J6 to y −1.3 and J3 0.1 mm outwards.
- New footprints in `louie.pretty` (from `gen_symbols.py`): `SolderPads_1x03/1x06_P2.54mm`, `TestPad_D1.0mm`.
- `just hull` (`hull_check.py`): envelope from the STL (radius, pocket, end caps).

**Status 2026-11-07 after round M (budget reached):** official board = round M, attempt 3, 14.1 mm wide;
`routing.json` matches (fingerprint 93e4000685). ERC 0, schematic parity 0, `antenna_intrusions` 0,
`power_width_violations` 0. Unconnected (`unconnected` 12, `drc_errors` 2):
- 1 signal: ISEN_ADC from R8 to the track at C14.
- 11 GND fill pieces on F.Cu/B.Cu without a via; they hang only on SMD pads (C8–C12, C16, C4/R3, D1, R15, R20,
  U1.14, U5). Under them, there is no free via site on any layer. `just route-check` shows: with rip-up, all 11 can be
  connected, but only if the ripped-up signals can be routed again afterwards.
- DRC: 2 × hole-to-hole spacing 0.275 instead of 0.28 mm between a router via (VBUS, (10.47; 4.53)) and the drill of the
  J4 tab S1. `route_fix.py` approximates the slot drill as a circle, which falls short by 5 µm here.

Proposals (decision by the project owner):
1. GND connection before signal routing: `route_fix.py` first places a via for every GND SMD pad (fanout) and routes
   the signals around them afterwards, instead of connecting islands retroactively at the end.
2. Enter drills as slots instead of circles in the blocking grids (S1 tabs of the USB-C receptacle).
3. Small relaxation: count fill pieces without a via that hang only on SMD pads as a soft metric in the score
   (`gnd_islands`) instead of as `unconnected`. This would be a change to the approved hard constraints.

**Round N (2026-11-07, approved proposals 1 and 2):**
- `route_fix.py`: `GND_FANOUT_FIRST = True` – before signal routing every GND SMD pad without a nearby via gets a short
  stub to its own via to In1 (`gnd_fanout()`, legal site only, no via-in-pad, not in the antenna keepout); the island
  anchoring at the end stays as fallback. `OVAL_DRILLS = True` – slot drills are blocked as capsules. The DRC error
  of round M was actually via hole to THT pad copper (project rule 0.28 mm, inner 0.30 mm, router used 0.25 mm);
  the via mask now uses the THT hole clearance for plated through pads.
- `just route-check` (new cases 5 and 6): the round-M via spot next to J4 S1 is now blocked; fanout on the unrouted
  board places 55 vias, 2 pads without a site (J4.A1, J4.B12, both next to the shell tabs, which are GND anyway),
  0 DRC errors.

| Round | Change | Result |
|---|---|---|
| N | fanout first, THT/slot clearance, fresh `just pcb` | own router, 4 attempts |
| Long run (2026-11-10) | 120 attempts with pre-router variants (none, krt, krt-novip) | rev A complete: 19 attempts without hard violations; the gate took attempt 39 (own router, via cost 30, seed 2, pre-router krt-novip); after removing a 0.07 mm 3V3 stub DRC 0 / 0 warnings / 0 unconnected, 157 vias, 808 mm |
| Rev B buck trial (2026-11-11) | buck block U3/L1/C8/C9 with locked pre-routes | 8 attempts, 5 complete; superseded the same day |
| Rev B LDO (2026-11-11) | LDO block U3/C8/C9 with locked pre-routes and 3V3 trunk (2.7) | 8 attempts, 7 complete; current baseline, 11.4 |

### 11.8 Board width 14.1 mm (status 2026-11-06)

Task from the space optimization analysis: widen the board from 13.5 to **14.1 mm** (fallback 14.0 mm).
- AA Ø 14.5 mm; at board height (z −0.3 … +0.5 around the cell axis) the circle is still 14.47 mm wide, 14.1 mm leaves
  room for the outline tolerance at JLC (±0.2 mm, uncertain, depends on the routing).
- Gain approx. 27 mm²: one more longitudinal track per edge and layer, especially at +y under J4 (SDA/SCL/INT next to OUT_B).
- Components at the new edge: at most approx. 1.2 mm above the top side (0402 fits).

Implementation (all generated):
- `board_outline.py`:
  - `WIDTH_MM = 14.1`.
  - Ends as a tongue (`TONGUE_W = 12.5`, `TONGUE_L = 0.8`, this is how far the board reaches into the caps).
  - Inner corners R 0.5 mm (1.0 mm cutter), outer corners R 0.3 mm.
  - Recess in front of J4 (`RECESS_X` 10.8 … 19.8, `RECESS_DEPTH` 0.3): the receptacle opening stays 0.7 mm behind the edge.
- `gen_main_pcb.py`:
  - `BOARD_W` from `board_outline.py`; edge tracks OUT_A/OUT_B, edge and antenna keepout areas grow with it.
  - Additional edge keepout areas at the tongue corners and at the recess; the antenna area stays copper-free.
  - The DRC check "silkscreen at the board edge" is disabled (`ignore_silk_edge()`): the
    pin-1 circle of the module footprint now lies on the edge, the manufacturer cuts it off.
- `sleeve.scad`: `pcb_w = 14.1`; new parameter `pcb_tongue_w = 12.5` for the cap slot (previously coupled
  to `pcb_w`). The shell stays the same: at the height of the board bottom side it is 14.49 mm wide on the inside.
- `plot_layout.py` draws the outline from Edge.Cuts.
- Envelope (`just model`, `just hull`):
  - Largest radius 7.06 mm at the board edge (x ±21.9, y ±7.05, z +0.43), below 7.25 mm.
  - J4 unchanged at 6.94 mm.
  - Bottom |y| ≤ 3.35 mm; the end caps are clear.
  - Component height on the bottom as in 11.7: generic U6 model 1.64 mm, real part 1.45 mm.

---

### 11.9 Bottleneck at the right module pins (status 2026-11-09)

Analysis with 13 attempts: SENSE, ISEN_ADC and VBAT_ADC stayed open in most attempts – always the same zone at the
right lower module corner (x ≈ 96–103), where the fan-out of pads 15–20 (SDA, SCL, USB, LED) meets the ADC lines.
Causes: the VBAT divider R6/R7 sat far from its ADC pin (R7 at x = 108), a locked GND fanout via sat in the 0.7 mm
gap between pads 12/13 and C13/C14, and the USB pair runs as a horizontal wall on F.Cu.

Current state (generator):
- `placement.py`: **R6/R7 next to C13** at the ADC pin (VSYS from U3 pin 3), **R2/C12 (EN) at the top right module
  corner** near J3.1 (side by side; their courtyards overlap by 0.08 mm, pads 0.34 mm apart – stacked instead they
  blocked pads 22–25). R8 stays (no room below the USB pair).
- `gen_main_pcb.py`: `preroute_adc_stubs()` replaces `preroute_vbat_escape()` and locks pad 12 → C13, pad 13 → C14,
  C13 → R6 and R6 → R7.
- `route_fix.FANOUT_MODULE_CLEAR` (keep fanout vias away from the module pads) exists but is off: in front of all
  23 signal pads it displaced GND vias and left IO8 open.

Result (6 attempts each, open connections): before 9/5/7/5/5/7; V1 placement alone 3/1/2/2/1/3; **V1 + ADC stubs
0/1/0/1/1/1–2** (several runs), DRC errors 0. USB pair on In2 instead of F.Cu was worse (3/3/5/3/0/2) and is not used.
Hole edge to hole edge 0.45 mm for different nets (JLC value, measuring method unverified;
`route_fix.HOLE_TO_HOLE`, default 0.25) costs a little: 1/4/1/1/2/1, MOT_IN1 at the top right corner.

**EN RC:** R2/C12 now sit approx. 10 mm from the EN pin (pad 8). Espressif recommends the RC close to EN; to be
assessed in the datasheet review.

### 11.10 Review findings accepted for this revision (status 2026-11-10)

From the datasheet and wiring review (wiring-review.md); checked whether placement can improve them:
- **C12 (EN capacitor) approx. 12 mm from EN pad 8:** pad 8 is on the module edge at the board edge; the best free top
  spot would be 9.6 mm, the former place (approx. 7 mm) now holds the VBAT divider. EN has a continuous GND reference on
  In1; C12 mainly sets the reset delay. Accepted; prototype check test-hardware.md 6 (power cycles, noise).
- **No 3V3 capacitor at module pad 3:** below it is the board edge, to the left the antenna keepout, above it the
  module. A DNP 10 µF footprint on the bottom under pad 3 (tested as C19) made routing worse (2.7 instead of 1.7
  unconnected on average, no complete attempt) and was dropped. The module has its own decoupling; C9/C10 sit
  about 14 mm away at the 3.3 V regulator. Accepted; measure 3V3 at the module during Wi-Fi TX (test-hardware.md 6).
- **C15 approx. 6 mm from the LIS2DH12:** no closer free spot; the sensor draws a few µA. Accepted.
- **No external pull-up on IO9 (BOOT):** internal pull-up, only the service pad J3 is connected; a resistor would need a
  track through the bottleneck. Accepted; boot check test-hardware.md 6.

LED LDO U6 after the 4 × AA change: its VIN pin is locked to the battery VSYS track on the bottom
(`preroute_led_ldo()`), and R22 sits next to its EN pin. Before, VSYS and IO15 stayed open in most attempts
(1.7 → 1.0 unconnected on average, 2 of 6 attempts complete).

## Sources

- Footprints: `/usr/share/kicad/footprints/RF_Module.pretty/ESP32-C6-MINI-1.kicad_mod`, symbol `/usr/share/kicad/symbols/RF_Module.kicad_sym`, board `hardware/main-board/louie-main.kicad_pcb` (pcbnew), all verified
- LCSC product API and JLC parts search (prices, stock, 2026-11-02): [C5736265](https://www.lcsc.com/product-detail/C5736265.html), [C42403058](https://www.lcsc.com/product-detail/C42403058.html), [C22407186](https://jlcpcb.com/partdetail/C22407186)
- Mouser ESP32-C6-MINI-1-H8 (search hit, stock/price uncertain): <https://www.mouser.de/c/?q=ESP32-C6-MINI-1-H8>
- [ESP32-C6-MINI-1/1U datasheet](https://documentation.espressif.com/esp32-c6-mini-1_mini-1u_datasheet_en.html)
- [JLCPCB PCB Capabilities](https://jlcpcb.com/capabilities/pcb-capabilities) (manufacturing rules, 11.2, retrieved 2026-11-03)
- Stack-up JLC04081H-3313: [Hive-RSI-Lab/hive-hwde PR 533](https://github.com/Hive-RSI-Lab/hive-hwde/pull/533/files) (from the template of the JLC impedance calculator, 2026-11-01, uncertain); [JLC impedance calculator/stack-ups](https://jlcpcb.com/impedance) (values only via JavaScript, not read)
- Freerouting 2.5.0 (`tools/freerouting.jar`, build 2026-10-05): log message "declared as a power layer but no plane is defined … treated as a signal layer" (chapter 11.4)
- [ST USBLC6-2 datasheet DS4260](https://www.st.com/resource/en/datasheet/usblc6-2.pdf) (Rev 5, Fig. 1/7/18, 2.4)
- [TI DRV8213 datasheet SLVSGV9](https://www.ti.com/lit/gpn/drv8213) (pinout DSG, IPROPI, VREF 510 mV, autosleep, RθJA)
- [ESP-IDF RF Coexistence ESP32-C6](https://docs.espressif.com/projects/esp-idf/en/stable/esp32c6/api-guides/coexist.html) (IDF v6.1)
- [esp-zigbee-sdk](https://github.com/espressif/esp-zigbee-sdk)
