ditschi/looping_louie/docs/review-2026-11-10.md

# Concept and hardware review (2026-11-10)

Status: 2026-11-10 · Review of the current concept, the main board, the charger board, the mechanics, the firmware
plan and the operation concept. Read: all documents in `docs/`, `hardware/bom/parts.csv`, the schematic generator,
`sleeve.scad`, `board_outline.py`, `routing.json`, and the step-0 firmware in `firmware/louie-fw`. No hardware was
measured and nothing was built; everything below is a desk review against the documents and the design data.

Open items that already exist (F/A/T/S/L/P numbers) are referenced, not repeated. New findings carry the prefix
**R**. Decisions stay with the project owner; where this review makes a recommendation it says so.

## Rating

| Rating | Meaning |
|---|---|
| **Important** | Fix or decide before the prototype order, or before firmware step 4 (motor). Otherwise a board revision, a rework or a concept change later is likely. |
| **Good** | Worth doing in this revision: small effort, clear gain, low risk. |
| **Optional** | Later revision, or only if a test shows the need. |
| *(verify)* | A measurement or a look at the real toy decides; the proposal says what to measure. |

## Summary

The concept is thorough and the hard questions (motor driver, lever detection, power path, coexistence, protocol,
backpressure, OTA) are analysed to a depth that is unusual for a hobby project. The datasheet review found no wiring
errors. The main risks are now not analysis gaps but **things only a physical test can answer** and a handful of
**interactions between subsystems** that the single-topic documents do not cover:

1. **Brake masks the lever** (R-C1): in brake and in every "motor off" phase, SENSE reads "lever open" and no
   current flows, so neither detection method works. Every motor-off state must be coast, and the step-0 firmware
   does the opposite.
2. **4 × AA support degraded the primary Li-ion case** (R-B1): higher LDO dropout and quiescent current, a thermal
   limit of the LDO in hotspot mode, the Q1 body-diode case, and the charger board is incompatible. This deserves an
   explicit trade-off decision.
3. **Nobody has looked inside the toys yet** (R-E1): the LiPo in the base, the cable past the lid and the upright
   charger board all assume a passage between battery compartment and base cavity that is unverified for both models.
4. **The status LED is invisible in normal use** (R-A4): it sits in a closed battery compartment, but several
   concepts (network mode, gesture windows, Zigbee mode) treat it as the only display.
5. **The project loop has run without hardware feedback for a long time** (R-A1): the dev board costs 14 €, the
   prototype batch about 105 €, and most remaining open items are measurements.

Recommended order: R-A3/R-E1 (open the toys, 30 min) → R-B1 decision → R-C1 rule into the firmware concept → trivial
schematic fixes (R-B3, R-D1, R-D2) → finish routing by hand (R-A2) → order → dev board and pre-order checks in
parallel.

---

## A. Concept and project process

| # | Finding | Why it matters | Proposal | Rating |
|---|---|---|---|---|
| **R-A1** | **Analysis has outrun feedback.** About 700 KB of documents, a step-0 firmware that was never compiled, no dev board, nothing ordered. Most open items (A2–A7, T1–T9, F17, W14) are measurements. | Every further analysis round costs time without reducing the main risks; a revision after the first prototype is planned anyway (test-hardware.md 7.5). | Freeze the schematic except for the trivial fixes in this review. Buy the dev board now. Order 5 boards as soon as routing is complete (R-A2). Treat rev A explicitly as a test article: a second order is already budgeted in cost-estimate.md. | **Important** |
| **R-A2** | **The "nothing in the GUI" principle blocks completion.** Routing has been at 12 unconnected (1 signal, 11 GND pieces) and 2 DRC errors since round M; rounds K–N each cost hours of CPU time and generator changes. | A prototype with hand-finished tracks is just as valid as a generated one. The generated placement and pre-routes are the valuable part; the last 5 % of routing is not. | Finish the remaining connections in KiCad by hand, run DRC, check in the `.kicad_pcb` as the authoritative board for rev A. Keep the generator for placement and pre-routes and let `route_fix.py` import hand-made tracks as locked pre-routes if the generator is re-run. Alternative (smaller gain): relax the rules to JLC's 0.1/0.1 mm only in a rule area around the module fan-out (R-D4). | **Important** |
| **R-A3** | **The real toys have not been opened.** Base cavity (P1), passage compartment ↔ base, lid geometry (L1), compartment width at the ribs (A1) and a possible diode in the new model (T2) are all unverified, and all of them can be checked in half an hour with the two models that are on the shelf. | Several concept pillars depend on them (R-E1, R-D7). | Put "open both toys, measure, photograph into `docs/images/`" at the top of open-items.md section 1, before the dev board. | **Good** *(verify)* |
| **R-A4** | **The status LED D1 is not visible in use.** On the new model the compartment has a lid; on the old model the insert sits in the C adapter inside the base. Yet software-concept.md 6.4 (network mode), web-ui-concept.md 4.1 (gesture window), idea-zigbee-operation.md ("the only display") and firmware-architecture.md 6.4 (offline selection) rely on it. | Without a visible indicator, hotspot vs. Wi-Fi, gesture windows and "Louie is asleep" are invisible to a user without a phone, which is exactly the user the LED is for. | Make an **external LED on J7** (pads exist, "single LED ... without parts") a standard kit part: a 3 mm LED on 10 cm of wire, glued to a visible spot (lid edge, base). Keep D1 as a debug aid. Alternatively short motor twitches as feedback, which only work with the lever closed. | **Good** |
| **R-A5** | **Scope of V1.** Mode builder V1, UI package with manifest, 16 languages, wireless buttons, Zigbee mode and workshop are all listed as planned. The stage tables exist but differ between documents (software-concept.md 10, web-ui-concept.md 6.3, mode-builder.md 8). | A clear V1 cut keeps the first firmware shippable. | One V1 table in firmware-architecture.md 11 that the other documents reference; everything else "later". | **Optional** |

## B. Power supply and power path

| # | Finding | Why it matters | Proposal | Rating |
|---|---|---|---|---|
| **R-B1** | **4 × AA support (decision 2026-11-09) costs the Li-ion case more than the documents say.** The switch AP2112K → SPX3819 brings: quiescent current 90 µA typ / 150 µA max instead of 55 µA (N17; A3 still says 55 µA); dropout up to 450–610 mV instead of 250 mV → cut-off at 3.6 V instead of 3.3–3.4 V, i.e. roughly 10–15 % of a LiPo's capacity unused; at 6.4 V and 100–150 mA average (hotspot mode has no modem sleep, firmware-architecture.md 7) the LDO dissipates 0.3–0.5 W in SOT-23-5 inside a closed compartment, close to its θJA limit (N17: about 135 mA average); Q1 does not block above 5.2 V (F28); the charger board must never be connected to an AA pack; MLCC stability of the SPX3819 is unverified (W14). | The primary use case (1S Li-ion with charger board) is made worse for a secondary one that has no mechanical home yet (where do 4 AA cells go?). | Decide explicitly, with the trade-off written down. Options: **(a)** drop 4 × AA, go back to a ≤ 6 V LDO with low dropout and low Iq (AP2112K, or a lower-Iq type); **(b)** keep 4 × AA with an LDO rated ≥ 7 V that has low Iq and low dropout (TPS7A26 was rejected for price/stock; re-check candidates such as AP7375, NCP718, both *unverified* here) and limit the average current in firmware (modem sleep in STA, client limit in AP); **(c)** support **3 × AA (max. 4.8 V) only**: fits the AP2112K's 6 V rating, removes the Q1 case and the LDO heat, and keeps a "no LiPo" path. Recommendation: (c), or (a) if nobody actually needs AA cells. **Update 2026-11-10:** the owner wants 3.0–6.6 V on one board; the worked-out option is a buck converter (TPS62162) instead of the LDO, see [proposal-supply-buck.md](proposal-supply-buck.md). | **Important** (decision) |
| **R-B2** | **Cut-off threshold vs. motor transients.** VSYS sags by I × (R_cell + R_path), estimated 0.4–0.8 V at start-up or stall (test-hardware.md 4.1). A cut-off at 3.6 V on an instantaneous reading (main.rs `VSYS_MIN_MV`) would end rounds with a half-full cell at the first stall. The documents disagree on the number (3.3–3.4 V in A3 and idea-usb-c-main-board.md, 3.5–3.6 V in wiring-review 7, 3.6 V in code). | Early false "low battery" stops are the kind of fault that makes a toy annoying; a too-low threshold risks brownout instead. | Define the rule once: warn on **filtered, low-load** VSYS (e.g. median over 2 s while duty ≤ 20 %) below 3.6 V; end the round at the next pause below 3.5 V; never evaluate during the first 300 ms of a ramp or during a stall; brownout reset is handled by E15. Measure sag in 4.1 and set the numbers from that. One table with the thresholds in main-board-c6.md 2.7, referenced everywhere else. | **Important** *(verify)* |
| **R-B3** | **F20 can be decided now.** VBUS_DET at 100k/100k is below VIH min at 4.75 V (W3); the VBUS node floats on Schottky leakage (W2). Both are value changes plus one 0402 bleed resistor. The firmware already uses `vbus_det` as a digital input for the USB + AA stall rule. | A marginal digital level on a wake pin and on a safety rule is not worth saving a resistor. | R14 → 68 k; 10–22 k bleed VBUS_J4 → GND; charger R105 → 10–22 k. Update `vbus_divider` in `louie_v1.rs`. | **Good** |
| **R-B4** | **Standby is dominated by the LDO.** About 100 µA total, of which 90–150 µA is the SPX3819. With a 1000 mAh LiPo that is roughly a year, acceptable; with a 1–2 µA LDO it would be years and the "lever closed at sleep" timer wake would matter less. | Ties to R-B1. | Part of the R-B1 decision. | **Good** |
| **R-B5** | **Ideal diode or power mux instead of D2/Q1** (F28). | Only matters if R-B1 keeps voltages above 5.2 V on BAT_IN. | Rev B, if R-B1 (b). | **Optional** |
| **R-B6** | **Two sources on BAT_IN is a user error the docs do not forbid.** J1 (charger board) and J5 (cell) are the same net; a cell on J5 plus the charger board on J1, or an AA pack plus a cell, puts two sources in parallel. | A kit that is given away needs this on the first page of the assembly notes. | One sentence in hardware-concept.md 5.4 and in the wiring section of charger-board.md: "exactly one source on BAT_IN; the charger board never together with AA cells". | **Good** |

## C. Motor, lever detection and safety

| # | Finding | Why it matters | Proposal | Rating |
|---|---|---|---|---|
| **R-C1** | **Brake masks the lever.** In brake (IN1 = IN2 = 1) both low-side FETs are on, OUT_A and OUT_B sit at GND, so SENSE reads 0 V = "lever open", and no motor current flows, so the current-based detection (hardware-concept.md 5.2) is blind as well. The same holds for every "motor off" phase that uses brake: `pause` segments, the "air pocket" spice, the post-stall brake, and setpoint 0 in main.rs (`State::Run` with `output_mv == 0` → `motor.brake()`). On the real board main.rs would then read SENSE low → `LeverOpen` → coast → SENSE high → `Run` → brake … at the tick rate. In addition, while driving forward SENSE is a 20 kHz PWM between 0 and about 3.3 V, and in reverse it is permanently LOW; the digital read `hw::level(p.sense)` in the Run state is therefore random. The concept knows "SENSE is not meaningful while driving", but no document states the consequence for brake and motor-off phases, and the step-0 code does not implement the current-based path. | This is the one interaction that would make the prototype look broken on day one, and it decides how `pause`, `stall` and stop are implemented in the core. | Rules for firmware-architecture.md 4.1: **every motor-off state is coast** (0/0 → autosleep, SENSE valid after about 1 ms); brake only as a transient (≤ a few 100 ms, e.g. the hard drop of a sawtooth, the stall reaction), with SENSE ignored during it; after a stall → brake 200 ms → coast. **While driving, the lever is evaluated by current only** (R-C2). Fix main.rs before it ever runs on `board-louie-v1` (coast at setpoint 0; lever from SENSE only when the driver is in coast). Document in main-board-c6.md 2.5. | **Important** |
| **R-C2** | **"Lever open while driving" by current alone is weak at low duty.** At minimum speed the motor current may be 100–200 mA → 25–50 mV at the ADC, against noise and offset; A6 covers accuracy, not the decision rule. | A false "lever open" stops the round; a missed one keeps PWM running into an open circuit (harmless, but the round state is wrong). | Define the rule: current < X mA for > 100 ms while duty > Y → suspect; confirm with a **short coast window** (2–5 ms every 100 ms) in which SENSE is sampled. The window costs about 2–5 % torque and nothing audible; the DRV8213 wakes from autosleep in 250 µs. This makes lever detection independent of the current scale. | **Good** |
| **R-C3** | **Lever semantics are not defined per state.** "Lever on = start" (software-concept.md 5.1) conflicts with: the lever gesture "next mode" in READY (firmware-architecture.md 6.4), the 3× handover gesture (web-ui-concept.md 4.1), the wizard's "confirm with the lever", pairing and test operation. The web UI concept solves some of these with explicit windows; the offline "next mode" gesture has no window. | Without one table, each feature will interpret the lever differently. | One table "lever edge → effect" per state (SLEEP, boot, READY, COUNTDOWN, RUNNING, PAUSE, END, wizard, gesture window, workshop). Use the existing **countdown** (web-ui-concept.md 5.1) as the gesture window: lever close in READY → countdown 1–3 s → start; further flips during the countdown are gestures. Countdown length as owner setting, 0 allowed when gestures are off. | **Good** |
| **R-C4** | **Wake-by-lever then needs a second flip (S1 open).** The lever closing *is* the wake event; "lever on at wake-up → no round starts" means the phone-less user (scenario S8) flips, nothing happens for 2–5 s, flips again. The surprise-start concern (lever bumped while the toy is put away) exists with the original toy as well, where the lever is the power switch. | The "playable without a phone" promise hinges on this. | Recommendation for S1: after a wake by SENSE, start the lever mode if the lever is **still closed about 1 s after boot** (motor thread before Wi-Fi, R-G8); keep "start only after release" as the owner option. | **Good** (decision) |
| **R-C5** | **Destructive lever gestures.** "Flip 10× at start resets the admin password and deletes the Wi-Fi networks" (software-concept.md 4.2). A child playing with the lever while the toy is switched on can wipe the configuration. S3 asks about reliability, not about the consequence. | Data loss by an unintentional gesture is worse than a slightly longer recovery path. | Gestures never delete anything. A gesture **opens a 10-minute open recovery hotspot** with a "reset owner password" button and shows the hotspot credentials; Wi-Fi networks stay. Ties to R-H1. | **Good** |
| **R-C6** | **IO2 floats when U4 is not fitted and J2 is empty.** `sleep.rs` disables the internal pulls on all `wake.high` pins, and INT has no external pull (R10/R16 are on SDA/SCL). A floating LP GPIO as an ext1 wake source gives random wake-ups and standby drain. | Pure firmware rule, easy to forget. | Enable the IO2 wake only when the I²C probe found the sensor or the owner enabled an external switch; otherwise LP pull-down on IO2. Note in firmware-architecture.md 7 (power). | **Good** |
| **R-C7** | **PWM at 20 kHz is at the edge of children's hearing.** The target audience hears up to about 18–20 kHz; motor and board may whine at the PWM fundamental. | Audible whine on a children's toy is a complaint; the fix is free. | 24–25 kHz (LEDC at 80 MHz still gives ≥ 11 bit). Test with children on the prototype (T9). | **Optional** |
| **R-C8** | **SENSE has no capacitor.** IO3 hangs on a 470 k source impedance connected to 30 cm of motor wiring through the toy; ESD and brush noise reach the pin directly (there is no TVS on OUT_A/OUT_B either, rejected for space). | Levels are fine; robustness is the question. Only a prototype test can tell. | A DNP 0402 footprint 1–10 nF IO3 → GND if routing allows (τ ≤ 5 ms with 470 k, no effect on the lever levels or the wake). Otherwise accept and do the ESD check in test-hardware.md 6. | **Optional** |
| **R-C9** | **F17 (IN1/IN2 during reset and deep sleep).** The analysis is complete; the measurement in 4.4 decides. | – | Keep the plan. Note that with R-C1 the firmware anyway must keep the driver in coast whenever it is not driving, so option a) (no pull-downs) only needs deep-sleep hold to work. | **Optional** *(verify)* |

## D. Main board: circuit details and layout

| # | Finding | Why it matters | Proposal | Rating |
|---|---|---|---|---|
| **R-D1** | **F23 and F25 are cheap and still open.** 100 nF at U5 pin 5 (W9); D1 LED without a part number (N2); C101/C102 → 10 µF (N13); voltages for C10–C14, C16 in parts.csv. | Each is one BOM line; the LED can be dark with a worst-case part. | Do them in the freeze (R-A1). USB series resistors (W10): accept. | **Good** |
| **R-D2** | **Hand-soldered pads without thermal reliefs.** All GND pads are connected to the fills without reliefs (main-board-c6.md 11.3), including the solder pads J1-4, J5-2, J2-2, J3-4, J6-6, J7-3 and the contact pads BT1/BT2 on L4 with the solid L2 plane 0.1 mm away. | The kit is hand-soldered exactly at these pads; a plane-connected pad on a 4-layer board needs a lot of heat and gives cold joints with a small iron. | Thermal reliefs (2–4 spokes) only for the hand-soldered footprints via the footprint's zone connection setting; the 0402 parts stay solid. | **Good** |
| **R-D3** | **BT1/BT2 are 2 × 2 mm SMD pads carrying bending force, contact pressure and the motor current.** A pad on L4 with a nickel strip soldered on and bent around the cap is the classic pad-lift case. F3 covers the contact mechanics, not the pad. | A lifted contact pad is a dead board. | Enlarge within the tongue (e.g. 3 × 4 mm), add a plated slot or two 0.8 mm holes to hook the strip through, or use castellated tongue edges. Decide together with the F3 print test. | **Good** |
| **R-D4** | **Design rules 0.15/0.15 mm while JLC allows 0.09/0.09 mm on 4 layers.** "Finer rules not needed" (11.9) was written while routing is still incomplete. | More room in the module fan-out would make the router's job and R-A2 easier. | Only if R-A2 (hand finish) is not wanted: a rule area with 0.1/0.1 mm around the right module pads. Otherwise leave. | **Optional** |
| **R-D5** | **GND-via-in-pad under the module (A17, 7–12 vias).** Unfilled vias in the module's thermal pad can wick solder during assembly. | JLC assembles ESP32-MINI modules routinely; the risk is a tilted module, not a dead one. | Accept for rev A; check the X-ray result; consider via tenting or moving the vias to the pad edge in rev B. | **Optional** |
| **R-D6** | **IO22 is free and J1-2 has no net.** The charger board's STAT could reach the main board on J1-2 → IO22 (through 10 k): "charging / full / no USB" in the UI instead of the VSYS > 4.3 V heuristic, which is tight against a full cell at 4.2 V. | Better battery UX for one wire and one resistor; but it adds a trace through the bottleneck. | Only if routing allows without cost; otherwise rev B together with charger board v0.2 (R-F2). | **Optional** |
| **R-D7** | **Envelope clearance 0.19 mm at the 14.1 mm board edge** (A1, 11.8) against compartments whose inner ribs are made for 14.0–14.3 mm cells. | A board that does not go in is a rev B. | Measure the inner width at the ribs of both compartments (R-A3) before ordering; `board_outline.py` keeps 14.0 mm as fallback. | **Good** *(verify)* |
| **R-D8** | **EN RC, 3V3 capacitor at the module, C15 and IO9 pull-up accepted (11.10).** Reasonable for rev A; the prototype test plan covers them. | – | Keep; the power-cycle and Wi-Fi-TX tests in test-hardware.md 6 are the gate for rev B. | **Optional** *(verify)* |

## E. Mechanics and installation

| # | Finding | Why it matters | Proposal | Rating |
|---|---|---|---|---|
| **R-E1** | **A passage between the battery compartment and the base cavity is assumed, not verified.** The LiPo lies in the base (hardware-concept.md 4.3), the charger board stands in compartment 2 with a cable to the main board (both cables cross the compartment wall or pass the lid), and the base holder needs a hole in the wall. The CDTM blog "had to make some room" in the old model; for the new model and Chewie nothing is known (idea-power-bank.md P1). | If there is no passage, "LiPo in the base" needs drilling, and the cable past the lid may keep the lid from closing (mechanics README, "open"). This is the biggest unverified assumption in the mechanics. | Open both toys (R-A3). If there is no passage: fallback ideas to evaluate are a **14500 Li-ion cell in compartment 2** in a printed sleeve with an insulated external bridge strip (cell charged outside or as a USB-C 14500 cell), or a battery pack mounted under the base with the cable through the lid. | **Important** *(verify)* |
| **R-E2** | **Charging requires opening the lid (variant A) or a hole in the base (variant B).** Correct as designed, but the README promises "without soldering" and does not say "the lid comes off to charge". | Expectation management for the kit. | One sentence in README "Components" and in charger-board.md 1. | **Good** |
| **R-E3** | **Print tests are independent of the PCB and still not done** (F3 strips, F4 support under J4, cap fit, C adapter). | Printed parts are the cheapest thing to iterate and can be tested with a 0.8 mm FR4 dummy cut to the outline. | Print and fit now, in parallel with the firmware toolchain. | **Good** |
| **R-E4** | **Wires to the optional pads J2/J3/J6/J7 have no exit** (mechanics README). | Only matters when options are used. | Second window on −y under J7 as a parameter in `sleeve.scad`. | **Optional** |

## F. Charger board

| # | Finding | Why it matters | Proposal | Rating |
|---|---|---|---|---|
| **R-F1** | **No cell temperature monitoring.** The MCP73831 has no NTC input; the cell lies in the base of a toy, next to a motor, and is charged at 500 mA in a closed space (L2 covers the IC's heat, not the cell's). Safety relies on the cell's PCM alone. | For a children's toy that is given away, charging without cell temperature supervision is the one safety gap a reviewer would name first. | For v0.2: a charger with a thermistor input and the same footprint class (MCP73833/4, 10-pin, or BQ24075 class), or at least 300 mA (R103 3.3 k) plus "protected cell with PCM only" in bold in the assembly notes. The 2-layer board has the space. | **Good** (safety) |
| **R-F2** | **v0.2 cleanup is known but scattered.** Drop D+/D− and reduce U102 to VBUS (charger-board.md note), C101/C102 → 10 µF (N13), R105 → 10–22 k (W2), STAT to J103-2 (R-D6), NTC (R-F1), reverse-polarity note (N6). | One list avoids a v0.3. | One "v0.2" list in charger-board.md 6. The v0.1 board can still be ordered for the prototype; it works as is. | **Good** |
| **R-F3** | **Reverse battery destroys U101** (N6, L3). | JST-PH packs come with both pinouts; the main board is protected, the charger is not. | Rev v0.2: a P-FET as on the main board (2 parts), or a DNP footprint for it; until then the silkscreen "+" and the note. | **Optional** |
| **R-F4** | **Play-while-charging current budget.** A 500 mA USB-A source with a 1 A motor sags VBUS until the cell helps through Q101's body diode (0.7 V, heat in Q101). charger-board.md describes it; nothing limits it. | Mostly harmless (short), but Q101 heat at a stall from USB is untested. | Firmware: when "USB on charger" is detected (VSYS > 4.3 V or STAT), lower the stall limit like F28 does for J4. Measure Q101 temperature in the prototype test. | **Optional** *(verify)* |

## G. Firmware (plan and step 0)

| # | Finding | Why it matters | Proposal | Rating |
|---|---|---|---|---|
| **R-G1** | **Step 0 has never been compiled.** Toolchain, bindgen names, `esp-idf-svc` 0.53 API, the path-with-spaces workaround and the ESP-IDF download are all unverified (README "What was checked"). | Every pre-order check (4.2–4.5) depends on it. | First task, before any further document: `just fw-build` on the dev machine; if the path breaks, clone to a path without spaces as the README suggests. | **Important** |
| **R-G2** | **R-C1 in code.** `main.rs`: brake at `output_mv == 0`; lever from `hw::level(p.sense)` in every state including Run. Fine in LED mode, wrong on `board-louie-v1`. | The README warns that the board variant "drives a real DRV8213". | Coast at setpoint 0; sample SENSE only when the driver is in coast; add the current-based lever rule (R-C2) in step 4. A comment in main.rs now, so nobody runs it on the prototype as is. | **Important** |
| **R-G3** | **`sdkconfig.defaults` vs. architecture.** The document requires `CONFIG_ESP_TASK_WDT_TIMEOUT_S=2`; the file sets only `CONFIG_ESP_TASK_WDT_PANIC=y` (IDF default 5 s). Bootloader rollback and the board-specific console (USB-Serial-JTAG) are known to be missing. | Small, but the dead-man chain in 4.1 counts on 2 s. | Add the line; create `sdkconfig.defaults.louie-v1` with the USB console when the board is built the first time. | **Good** |
| **R-G4** | **State traffic in hotspot mode.** 1.5–3 KB × 10/s × 8–10 clients = 120–300 KB/s ≈ 1–2.4 Mbit/s on a C6 SoftAP that shares airtime 50/50 with the BLE scan. The fast/slow split is listed as a fallback (5.3, 13). | A SoftAP with 8 phones is the least robust radio case the project has (C1); sending 2 KB of mostly unchanged player data ten times a second to each phone spends the budget on nothing. | Design the protocol as **fast/slow from the start**: a small 10 Hz message (phase, setpoint, time, seq) and a change-triggered player/permission message. Costs little in `louie-proto`, saves a redesign after step 3. | **Good** |
| **R-G5** | **Motor before Wi-Fi after a lever wake.** 4.1 fixes the GPIO/LEDC order; `current.json` (LittleFS) must also be read before Wi-Fi so the lever mode can start within about a second (R-C4). | Deep sleep → boot → Wi-Fi takes 2–5 s; the phone-less player waits. | Start order in `main`: GPIO → LittleFS mount and `current.json` → motor thread → game thread → Wi-Fi/BLE. | **Good** |
| **R-G6** | **Floating-point core on a chip without FPU.** `louie-core` plans `libm` sine/exponential in float; the C6 (RV32IMAC) has no FPU, so this is soft-float at 50 ms tick (fine) but bit-identity with WASM then depends on identical IEEE evaluation order and no fused operations. | Determinism is a stated goal (golden checksum device = PC). | Use integer fixed-point (mV, ms, ‰) in the core; sine/exp from small integer tables. Determinism becomes trivial and the ESP saves cycles. Decide before step 1 since it shapes the schema types. | **Optional** |
| **R-G7** | **`vbus_det` as a digital input for a safety rule** (USB + AA stall limit) with a marginal level (W3). | Ties to R-B3; if R14 changes, so does `vbus_divider`. | Read VBUS via the ADC and decide at 4.3 V, or fix the divider (R-B3). | **Good** |
| **R-G8** | **R-C6 (IO2 wake only with a sensor present)** and the lever-closed-at-sleep path (timer vs. wake-on-LOW) are both in `sleep.rs` as options without a policy. | – | Policy in firmware-architecture.md 7: lever closed at sleep → wake on LOW on IO3 (no timer); IO2 only when configured; IO4 always. | **Good** |

## H. Network, web UI and operation

| # | Finding | Why it matters | Proposal | Rating |
|---|---|---|---|---|
| **R-H1** | **The first-start hotspot password exists only on the console.** E17: random password at first start, "output on the console for the sticker". A recipient of the kit without the sticker (lost, or the builder forgot) cannot join and has no console. The recovery gesture "force hotspot" (software-concept.md 3.1) does not say whether that hotspot is open. | The gift scenario (S10) breaks on a lost sticker. | Hotspot **open until the setup wizard has finished** (owner password confirmed by the lever = physical access), then WPA2 with the random password, shown with both QR codes in the owner area for re-printing. The recovery gesture opens the hotspot for 10 minutes (R-C5). | **Good** |
| **R-H2** | **`louie.local` does not resolve on many Android phones.** Chrome on Android has no reliable mDNS resolver; the STA-mode promise "reachable at louie.local" (software-concept.md 3.1, 3.3) holds for iOS, macOS and most desktops only. | Half the phones at a family table are Android. | In STA mode show the IP in the setup result and on the status page, offer a QR with the IP, and set the DHCP hostname `louie` (many home routers then resolve `http://louie/`). mDNS stays for the others. The hotspot path (192.168.4.1) is unaffected. | **Good** |
| **R-H3** | **"Who may control: anyone" as default** (S5). | At a party any phone in range can take control while the game master is away for 15 s. | Default by profile: Family = anyone, Party = lever confirmation, Kids = owner only (the profiles already exist). | **Good** (decision) |
| **R-H4** | **Captive portal behaviour** (T8) and the "open in browser" button are planned; Windows/macOS probe URLs are listed in firmware-architecture.md 5.1. | – | Keep; add the test to step 3's "done when". | **Optional** |
| **R-H5** | **Sleep with open tabs is handled** (software-concept.md 6.4). The 1-minute warning needs a reachable client; on the hotspot the warning also tells the phone that the hotspot will vanish. | – | Add "hotspot ends in 60 s" wording to the warning in hotspot mode. | **Optional** |

## I. Documentation hygiene

| # | Finding | Proposal | Rating |
|---|---|---|---|
| **R-I1** | **hardware-concept.md is stale after the 2026-11-09 power change:** "VM directly from VSYS (3.0–5.5 V)" (5.1), "Inputs on A (3.0–5.5 V)" and "divider 470k/470k" (5.4, 5.5 table), "U3 AP2112K-3.3", "U6, F1, C17, R22, JP1 … TPS22918 … PTC" (5.5 component table), open item "AP2112K with an empty battery" (8). open-items.md A3 says "Quiescent current 55 µA" and "cuts off at approx. 3.3–3.4 V" (both AP2112K values). main-board-c6.md still carries "Status 2026-11-06" with content from 11-09/11-10. test-hardware.md 1 and 4.1 mention the AP2112K. | One pass after the R-B1 decision; put the supply numbers (VSYS range, LDO, cut-off thresholds, divider) into one table in main-board-c6.md 2.7 and reference it. | **Good** |
| **R-I2** | **"Without soldering" in the README** refers to the toy; the kit itself needs soldering (strips, cable, cell). | "No soldering on the toy; the kit needs about 6 solder joints" in README. | **Optional** |
| **R-I3** | decision-history.md: the 2026-11-09 row sits between two 2026-11-06 rows; wiring-review.md 7.4 has an orphaned table split. | Cosmetic. | **Optional** |

---

## Recommended order

1. **Open both toys** (R-A3, R-E1, R-D7): passage to the base, cavity, compartment width at the ribs, lid, diode in series. Half an hour, decides the mechanics.
2. **Decide R-B1** (4 × AA vs. Li-ion-first) and write the supply table (R-I1, R-B2).
3. **Concept rules into the documents:** R-C1 (coast is the only motor-off state), R-C3 (lever table), R-C4/S1, R-C5, R-H1, R-G4.
4. **Schematic freeze with the cheap fixes:** R-B3, R-D1, R-D2, R-D3 (pad shape after the print test), optionally R-C8.
5. **Finish routing by hand** (R-A2), DRC 0, JLC preview, order 5 boards with H8.
6. **In parallel:** dev board, `just fw-build` (R-G1), pre-order checks 4.1–4.5, print tests (R-E3), fix main.rs (R-G2).
7. Charger board v0.2 list (R-F2, R-F1) for the second order.

## Not reviewed

- Routing quality of the current board in detail (the board is unfinished; R-A2).
- Wireless-button and Zigbee documents beyond their summaries; the coexistence analysis looked sound.
- The cost estimate numbers (F13, a real quote replaces them).
- The ideas catalog (`ideas.md`) and the PoC UI.
