ditschi/looping_louie/docs/idea-wireless-buttons.md

# Idea: wireless buttons as players (joker by button)

Status: 2026-11-06 · **Decided: BTHome BLE buttons (received passively) are a planned feature for V1.**
Other radio paths are rejected (briefly in 4.3, reasons in [decision-history.md](decision-history.md)). Complements
[software-concept.md](software-concept.md), [web-ui-concept.md](web-ui-concept.md) (4.2),
[mode-builder.md](mode-builder.md) (2.5, 3), [device-pairing.md](device-pairing.md) (UI and data model)
and [idea-optional-hardware.md](idea-optional-hardware.md).

Question: *Can we pair e.g. 4 physical buttons wirelessly that trigger jokers (⏩ boost, ⏪ kickback)?*

Markers: **(verified)** = backed by a source · **(unverified)** = from memory, secondary source only, or
own estimate; measure in the feasibility test. Prices are rough guide values (DE/EU, at the time of research).

---

## Short answer

- **The ESP32-C6 supports Bluetooth Low Energy 5** (no Classic Bluetooth), as scanner and as central.
  Wi-Fi and BLE share the existing antenna. **No hardware change.** **(verified)** [datasheet][c6-mini-ds]
- **Chosen: BTHome buttons that only transmit** (Shelly BLU Button1 / Tough 1 / RC Button 4). The ESP listens
  passively, no connections. Events single/double/triple/long, up to 4 keys per device.
- **Main risk:** Espressif rates **BLE scan + own hotspot with connected phones** as "supported, but
  unstable" (C1); on home Wi-Fi as stable. **(verified)** [RF Coexistence C6][idf-coex-c6] RAM is no longer a
  bottleneck on the C6 (259 KB free heap in the IDF example Wi-Fi + BLE).
- **Wired buttons** on the player inputs J6 are the reliable reference and the test tool.
- **Stages:** Stage 0 = feasibility test with 1 Shelly button on the ESP32-C6-DevKitC-1 (test-hardware.md) in the hotspot with 6–8 phones
  ([test-hardware.md](test-hardware.md)). Stage 1 = BTHome buttons in **V1**.
  Antenna, coexistence and scan parameters: [analysis-wireless-controllers.md](analysis-wireless-controllers.md).

---

## 1. What the ESP32-C6 can do over radio

| Item | Value | Source |
|---|---|---|
| Bluetooth | **BLE 5.3**; **no Classic** (no BR/EDR, no classic HID) | **(verified)** [datasheet][c6-mini-ds] |
| BLE roles | Broadcaster, observer (scanner), peripheral, central | **(verified)** [datasheet][c6-mini-ds] |
| BLE PHY | 1M, 2M, Coded PHY (long range) | **(verified)** [datasheet][c6-mini-ds] |
| Wi-Fi | 802.11 b/g/n/ax 2.4 GHz | **(verified)** [datasheet][c6-mini-ds] |
| 802.15.4 (Zigbee/Thread) | yes, same radio | **(verified)** [datasheet][c6-mini-ds] |
| Antenna | **one** antenna, one radio for Wi-Fi, BLE and 802.15.4 | **(verified)** [datasheet][c6-mini-ds] |

**Long range (Coded PHY)** is of no use to us: off-the-shelf buttons transmit on 1M PHY, the table is small, and
Coded PHY packets are long and disturb Wi-Fi. **(verified)** [RF Coexistence C6][idf-coex-c6]

---

## 2. One radio for Wi-Fi and BLE (coexistence)

The C6 switches the radio between Wi-Fi and BLE. With "Wi-Fi connected" the period starts at the beacon
(> 100 ms); Wi-Fi and BLE each get e.g. **50 %**. **(verified)** [RF Coexistence C6][idf-coex-c6]

| BLE | STA connected | SoftAP beacon | **SoftAP connected** |
|---|---|---|---|
| Scan | Y | Y | **C1** |
| Advertising | Y | Y | **C1** |
| Connected | Y | Y | **C1** |

Y = stable · **C1 = supported, performance unstable**. **(verified)** [RF Coexistence C6][idf-coex-c6]

- **Home Wi-Fi (STA)**: stable. **Own hotspot with up to 8 phones = C1** → biggest risk, only measuring helps.
- Espressif advises keeping the default scan parameters under coexistence. **(verified)** [RF Coexistence C6][idf-coex-c6]
  For buttons, however, they are too sparse. Conflict of goals → in the test, try windows of 30…100 ms at 100 ms interval
  (parameters: [analysis-wireless-controllers.md](analysis-wireless-controllers.md) 1.3).
- WebSocket latency: at 50 % BLE share, Wi-Fi packets shift by some 10 ms **(unverified)**. For
  10 status updates/s not critical, as long as nothing is lost.
- Rule: BLE scan **only in READY/RUNNING and only when buttons are paired**. Without buttons, BLE stays off.

---

## 3. BLE in the firmware (Rust on ESP-IDF)

| Item | Status |
|---|---|
| Stack | **NimBLE** from ESP-IDF; in Rust first via the NimBLE wrapper of `esp-idf-svc` 0.53, fallback crate `esp32-nimble` ([firmware-architecture.md](firmware-architecture.md) E8) |
| Scan | passive, set interval/window explicitly, duplicate filter off (details: analysis-wireless-controllers.md 1.3) |
| Parser | BTHome decoding (UUID, objects, packet ID, button events) as a pure function in the hardware-free core crate → testable on the PC |
| AES-CCM | for encrypted BTHome buttons: mbedTLS in ESP-IDF has CCM; alternatively RustCrypto crates `aes` + `ccm` **(unverified: not tried yet)** |
| RAM | IDF example Wi-Fi + BLE: **259 KB** free heap on the C6 **(verified)** [techpedia]. In the test, measure the largest free block under load. |

---

## 4. The options

### 4.1 BLE BTHome buttons (transmit only) – chosen

**Protocol** **(verified)** [BTHome format][bthome-format]: service UUID `0xFCD2`; first byte: bit 0 =
encrypted, bit 2 = "trigger-based"; object `0x00` = **packet ID** (evaluate only on change → duplicates gone);
object `0x3A` = button: `0x01` press, `0x02` double, `0x03` triple, `0x04` long, `0x80` held.

**Shelly BLU Button1** **(verified)** [user manual][shelly-manual], [Shelly BLE API][shelly-api]:
transmits BTHome for **1 second** after a press; **LED ring and buzzer** show the number of presses; AES-CCM
possible; CR2032 up to 2 years; range up to 10 m indoors; 36 × 36 × 6 mm. **Multi-click window adjustable**:
800 / 550 / 300 / 150 / 90 / 55 ms. Configuration: hold 10 s → connectable via GATT for 1 min.

**Shelly BLU RC Button 4 / Wall Switch 4**: **every packet contains all 4 keys** as four `0x3A` objects at
fixed positions; same events and click setting. **(verified)** [RC Button 4 API][shelly-rc4]

**Passive is enough:** The BTHome data is in the advertising. In Home Assistant, passive scanning resolved delays
with Shelly buttons **(verified, forum)** [simon42][simon42] → observe in the test as well.

**Latency** button → motor:

| Step | Time |
|---|---|
| Button waits for a possible 2nd click | 55 / 300 / 800 ms (setting) |
| Packet sent and received (advertising interval, scan window, 50 % airtime) | approx. 20–100 ms **(unverified)** |
| Callback, parser, game logic, motor task | approx. 1–10 ms **(unverified)** |
| **Total** | **approx. 80–170 ms** (55 ms) · **approx. 330–420 ms** (300 ms) · approx. 0.9 s (800 ms) |

For comparison: the hold button on the phone triggers after `hold_ms` **400 ms** (mode builder 2.5). A button with a
300 ms window is therefore **as fast as the phone**.

**Double-click problem**: With single = ⏩, double = ⏪, **every** single press waits for the window, and below
300 ms children cannot double-click reliably. Solutions: (1) **one key per joker** (RC Button 4,
window 55 ms) – recommended; (2) one button, only one joker; (3) single = ⏩, **long = ⏪** (whether "long" comes when the
hold time is reached or on release: **(unverified)**); (4) single/double with 300 ms.

**Reliability**: 1 s of repeats + packet ID → missed presses unlikely; **measure** in hotspot mode
(C1). Two quick single jokers can arrive as a double click.

**Other BLE advertisers**: Xiaomi/Mijia buttons transmit encrypted (MiBeacon), key only via the
Xiaomi cloud **(unverified)** → not recommended.

### 4.2 Wired (reference and test)

The main board has player inputs **S1–S4 on J6** (IO5, IO20, IO21, IO8; pin assignment
[main-board-c6.md](main-board-c6.md) 2.3). Arcade buttons directly to GND, **no port expander**. Latency
< 10 ms, 100 % reliable, no batteries, cost approx. €5–15 for 4 buttons and cable. Disadvantage: cables across the
table. Good as a **test tool** for the game logic ("button player") and as an emergency solution if BLE does not hold up in the hotspot.
Details: [idea-optional-hardware.md](idea-optional-hardware.md).
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
