ditschi/looping_louie/docs/images/board-bottom.png

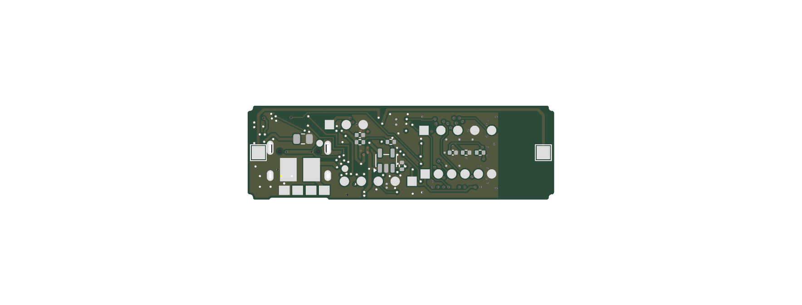
docs/images/board-bottom.png
