ditschi/looping_louie/docs/images/charger-board-bottom.png

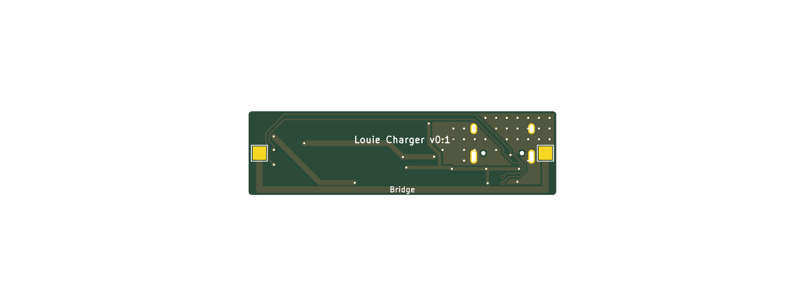
docs/images/charger-board-bottom.png
