ditschi/looping_louie/docs/images/charger-schematic.png

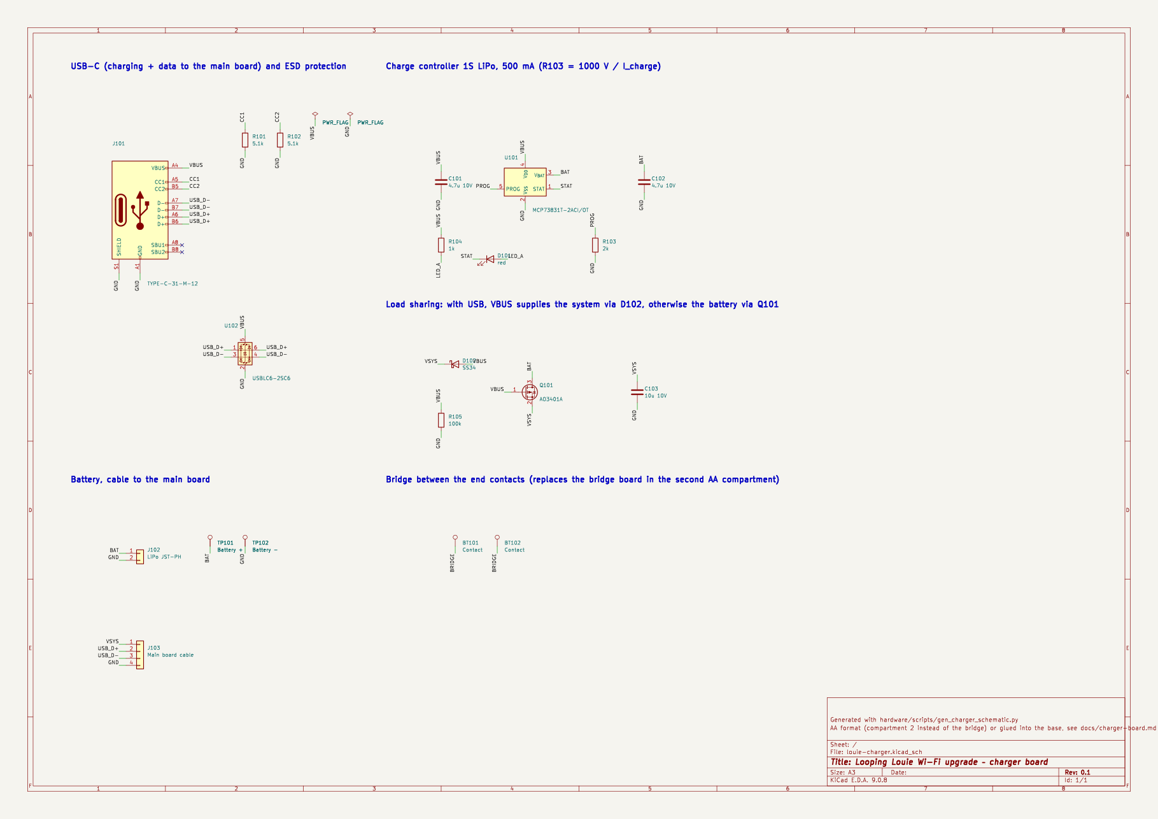
docs/images/charger-schematic.png
