ditschi/looping_louie/docs/images/copper-bottom.png

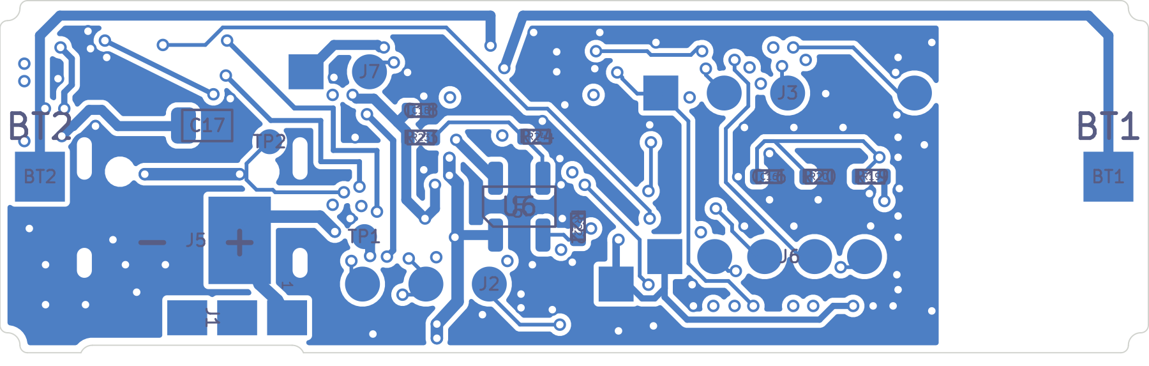
docs/images/copper-bottom.png
