ditschi/looping_louie/docs/images/copper-l2-gnd.png

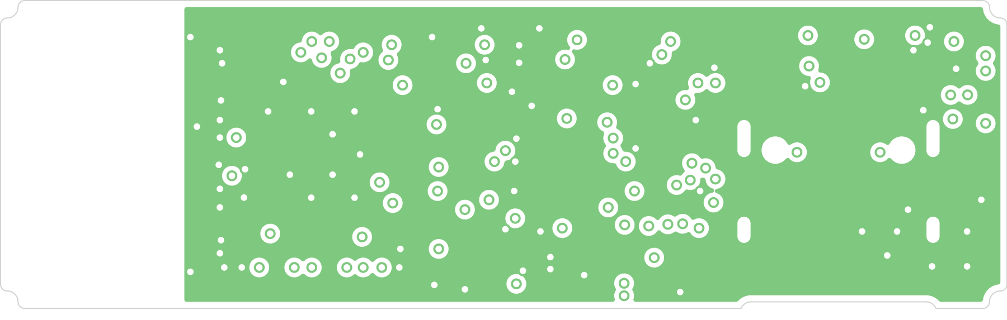
docs/images/copper-l2-gnd.png
