ditschi/looping_louie/docs/images/copper-l3-signal.png

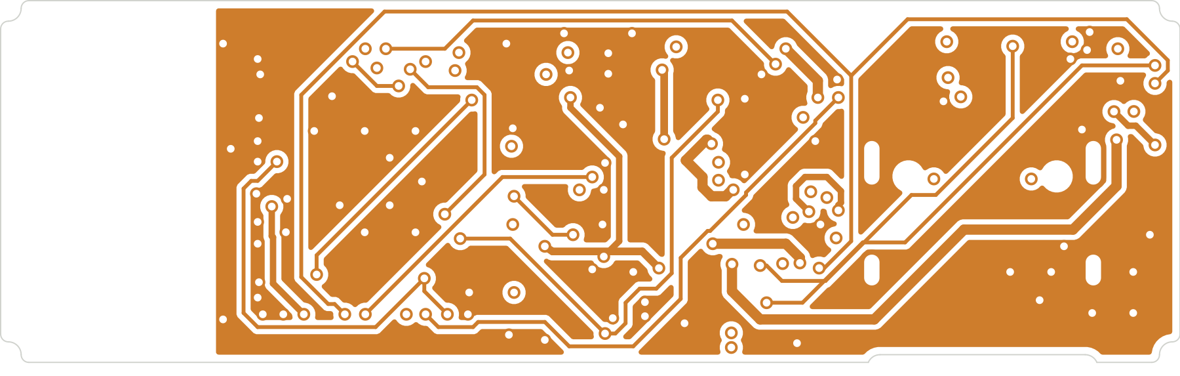
docs/images/copper-l3-signal.png
