ditschi/looping_louie/docs/images/copper-top.png

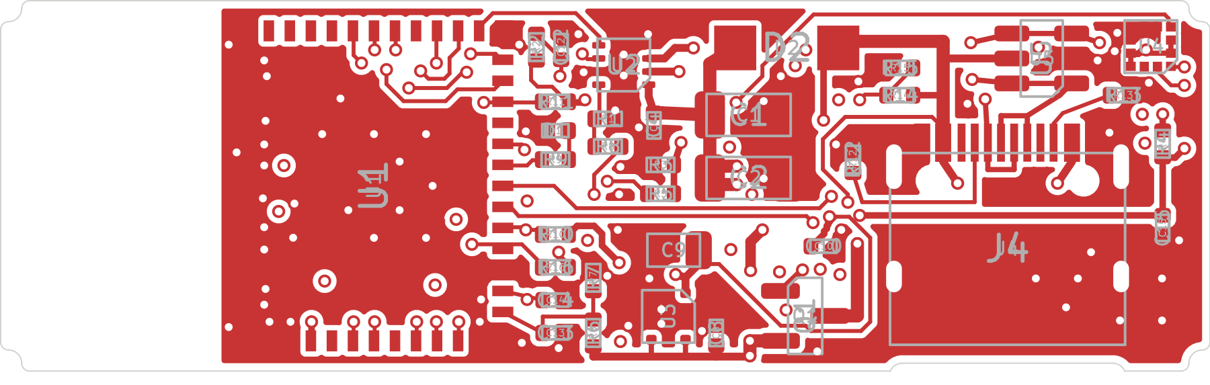
docs/images/copper-top.png
