ditschi/looping_louie/docs/images/placement.png

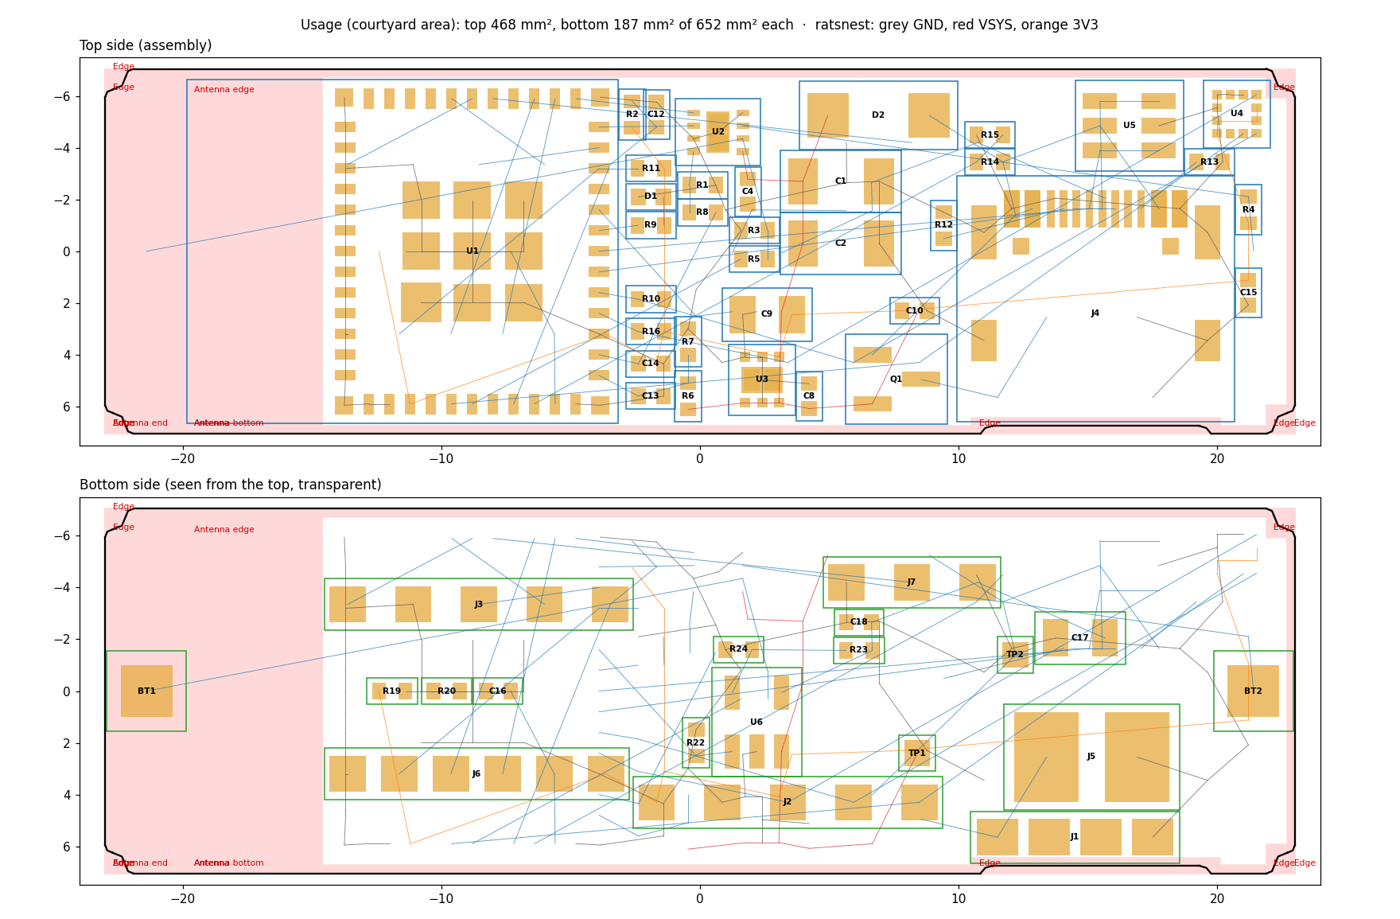
docs/images/placement.png
