ditschi/looping_louie/docs/images/schematic.png

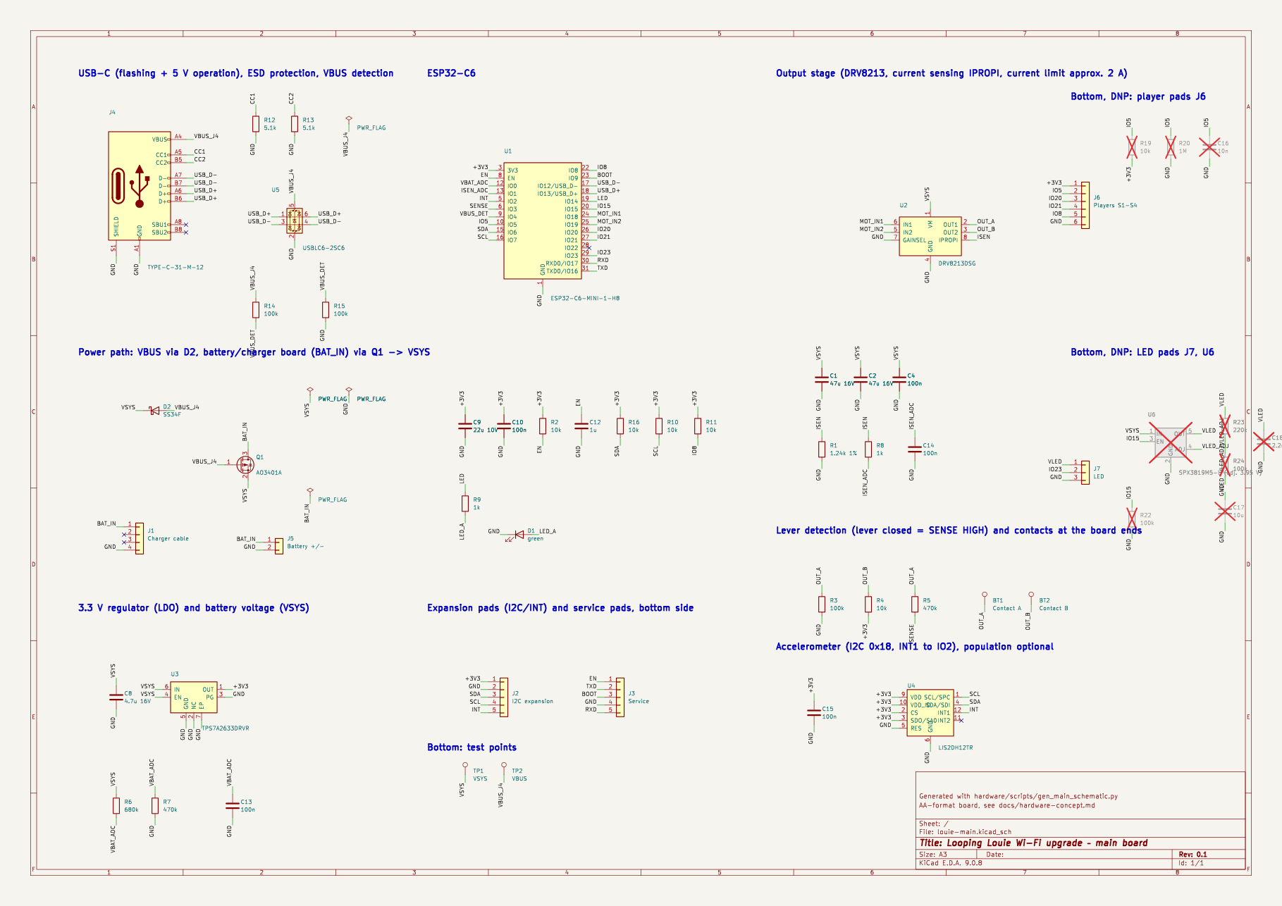
docs/images/schematic.png
