ditschi/looping_louie/hardware/main-board/louie-main.kicad_pcb

## KiCad design hardware/main-board/louie-main.kicad_pcb (2026-11-11)

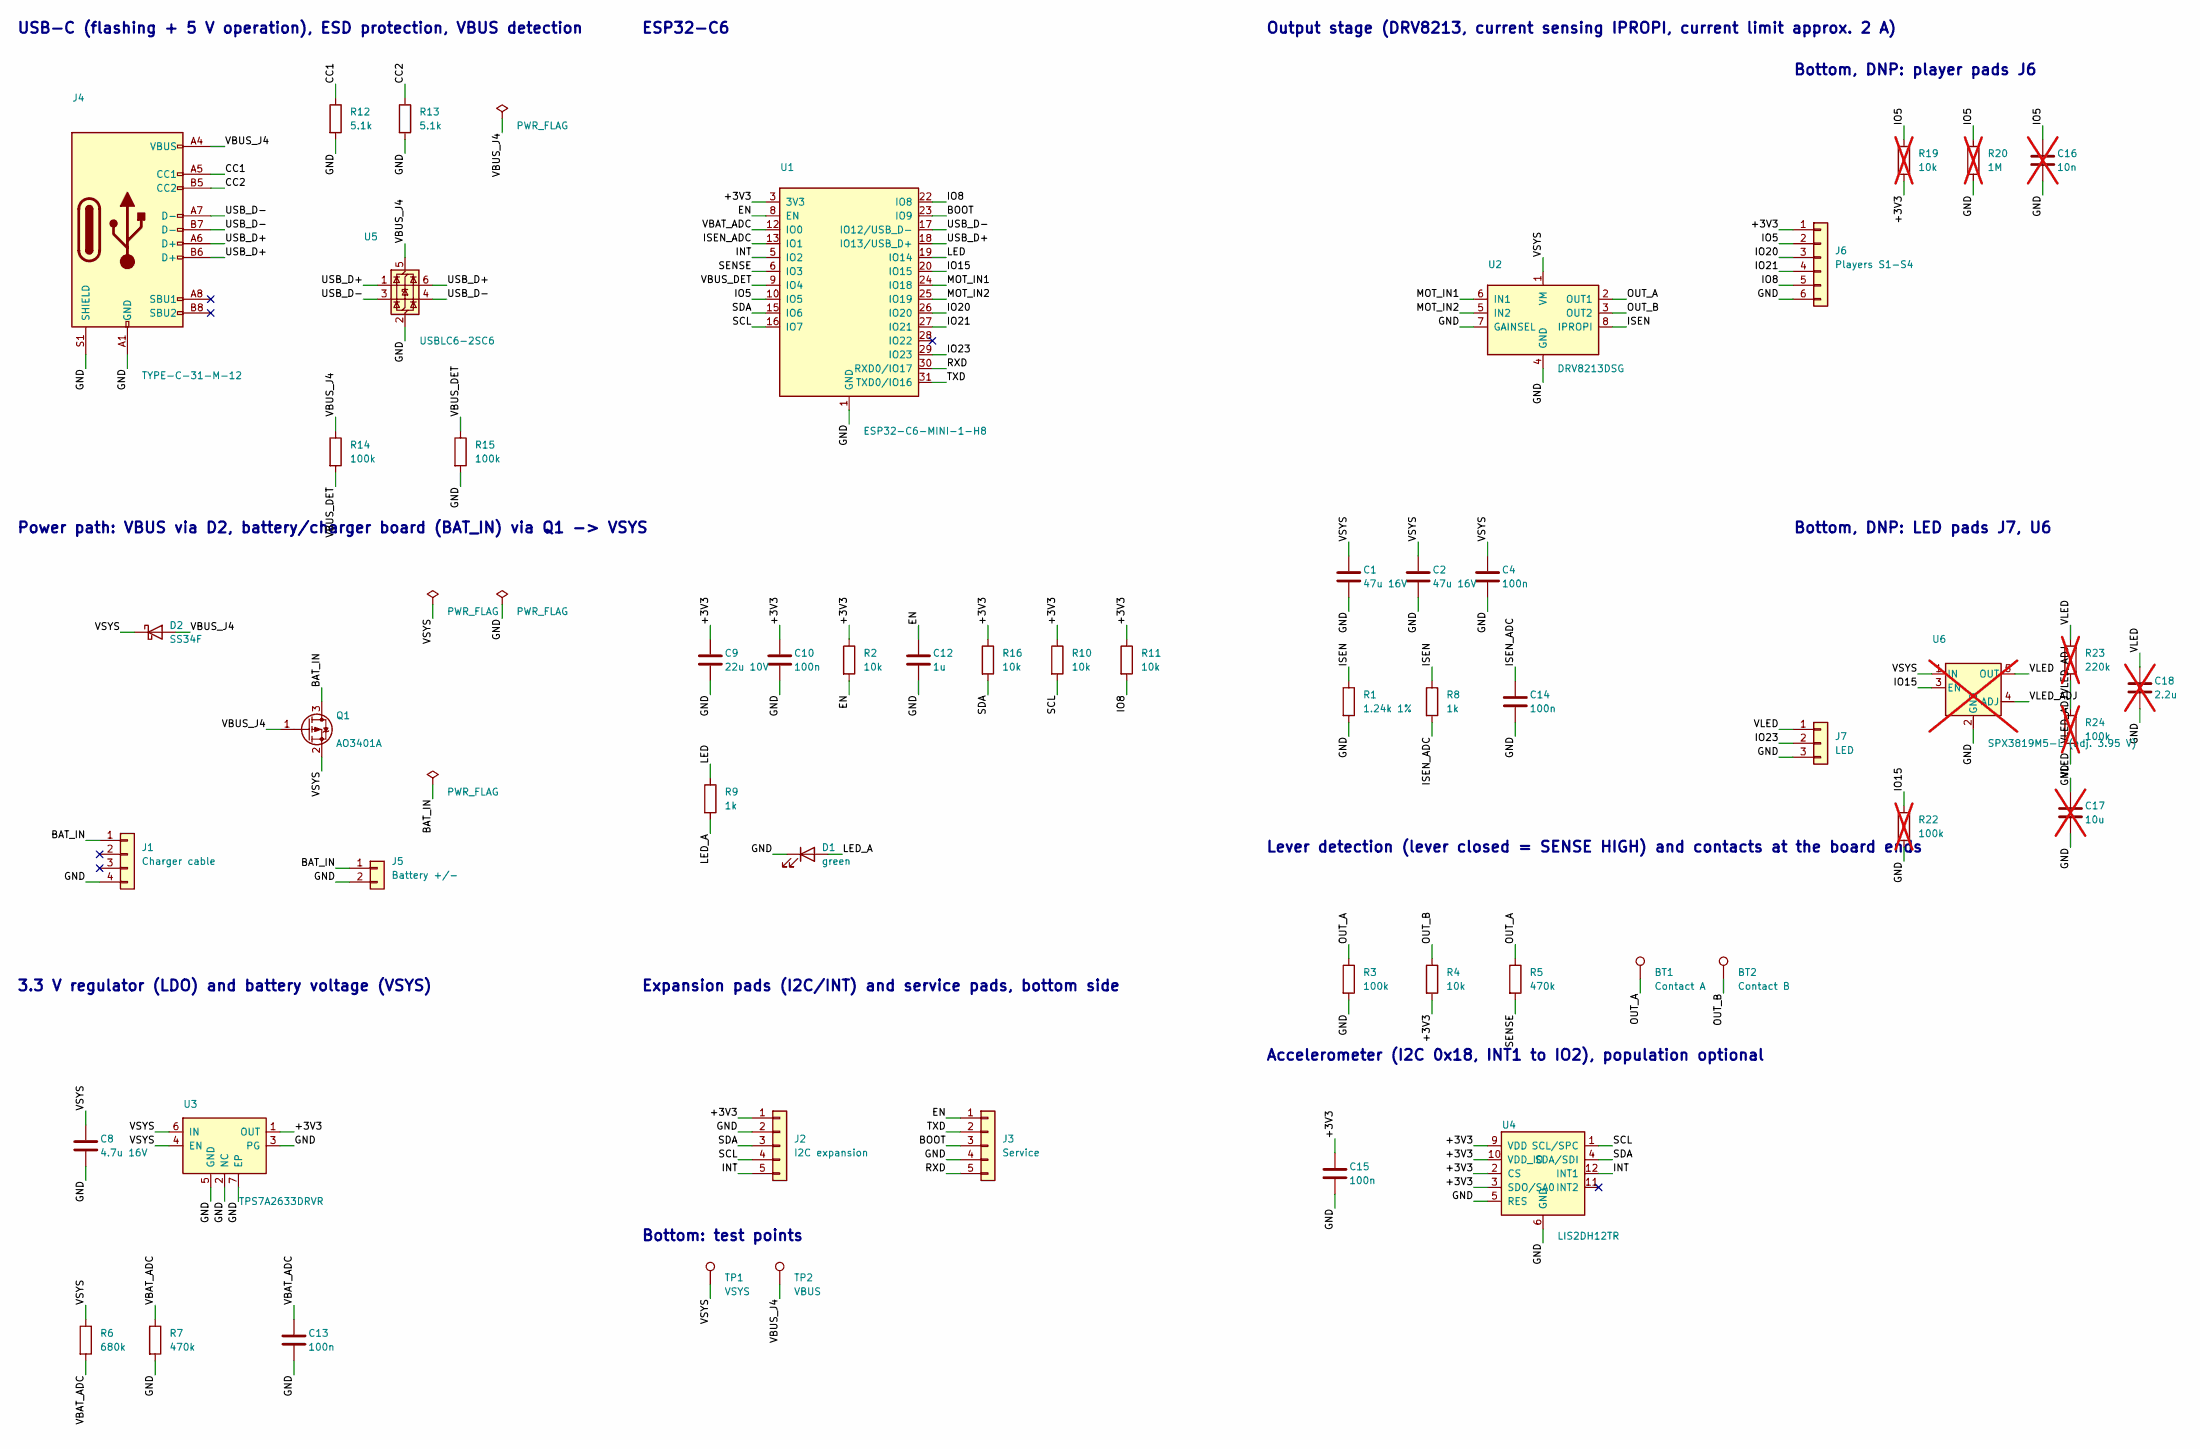
[picture p19: schematic louie-main.kicad_sch, Looping Louie Wi-Fi upgrade – main board]

Parts:
BT1: Contact A; TestPoint_Pad_2.0x2.0mm
BT2: Contact B; TestPoint_Pad_2.0x2.0mm
C1, C2: 47u 16V; C_1206_3216Metric
C4, C10, C13, C14, C15: 100n; C_0402_1005Metric
C8: 4.7u 16V; C_0402_1005Metric
C9: 22u 10V; C_0805_2012Metric
C12: 1u; C_0402_1005Metric
C16: 10n; C_0402_1005Metric; LCSC Part C15195; not fitted
C17: 10u; C_0805_2012Metric; LCSC Part C1713; not fitted
C18: 2.2u; C_0402_1005Metric; not fitted
D1: green; LED_0402_1005Metric
D2: SS34F; SMAF_L3.5-W2.6-LS4.7-RD; LCSC Part C60396
J1: Charger cable; SolderPads_1x04_P2.00mm
J2: I2C expansion; SolderPads_1x05_P2.54mm
J3: Service; SolderPads_1x05_P2.54mm
J4: TYPE-C-31-M-12; USB_C_Receptacle_HRO_TYPE-C-31-M-12; LCSC Part C165948
J5: Battery +/-; SolderPads_1x02_2.5x3.5mm
J6: Players S1-S4; SolderPads_1x06_P2.00mm
J7: LED; SolderPads_1x03_P2.54mm
Q1: AO3401A; SOT-23; LCSC Part C15127
R1: 1.24k 1%; R_0402_1005Metric
R2, R4, R10, R11, R16: 10k; R_0402_1005Metric
R3, R14, R15: 100k; R_0402_1005Metric
R5, R7: 470k; R_0402_1005Metric
R6: 680k; R_0402_1005Metric
R8, R9: 1k; R_0402_1005Metric
R12, R13: 5.1k; R_0402_1005Metric
R19: 10k; R_0402_1005Metric; LCSC Part C25744; not fitted
R20: 1M; R_0402_1005Metric; not fitted
R22: 100k; R_0402_1005Metric; LCSC Part C25741; not fitted
R23: 220k; R_0402_1005Metric; not fitted
R24: 100k; R_0402_1005Metric; not fitted
TP1: VSYS; TestPad_D1.0mm
TP2: VBUS; TestPad_D1.0mm
U1: ESP32-C6-MINI-1-H8; WIFIM-SMD_ESP32-C6-MINI-1; LCSC Part C42403058
U2: DRV8213DSG; WSON-8-1EP_2x2mm_P0.5mm_EP0.9x1.6mm; LCSC Part C22407186
U3: TPS7A2633DRVR; WSON-6-1EP_2x2mm_P0.65mm_EP1x1.6mm; LCSC Part C2876256
U4: LIS2DH12TR; LGA-12_2x2mm_P0.5mm; LCSC Part C110926
U5: USBLC6-2SC6; SOT-23-6; LCSC Part C7519
U6: SPX3819M5-L (adj. 3.95 V); SOT-23-5; not fitted

Connections:
/+3V3: C9.1, C10.1, C15.1, J2.1, J6.1, R2.1, R4.2, R10.1, R11.1, R16.1, R19.2, U1.3 (3V3), U3.1 (OUT), U4.2 (CS), U4.3 (SDO/SA0), U4.9 (VDD), U4.10 (VDD_IO)
/BAT_IN: J1.1, J5.1, Q1.3 (D)
/BOOT: J3.3, U1.23 (IO9)
/CC1: J4.A5 (CC1), R12.1
/CC2: J4.B5 (CC2), R13.1
/EN: C12.1, J3.1, R2.2, U1.8 (EN)
/GND: C1.2, C2.2, C4.2, C8.2, C9.2, C10.2, C12.2, C13.2, C14.2, C15.2, C16.2, C17.2, C18.2, D1.1 (K), J1.4, J2.2, J3.4, J4.A1 (GND), J4.A12 (GND), J4.B1 (GND), J4.B12 (GND), J4.S1 (SHIELD), J5.2, J6.6, J7.3, R1.2, R3.2, R7.2, R12.2, R13.2, R15.2, R20.2, R22.2, R24.2, U1.1 (GND), U1.2 (GND), U1.11 (GND), U1.14 (GND), U1.36 (GND), U1.37 (GND), U1.38 (GND), U1.39 (GND), U1.40 (GND), U1.41 (GND), U1.42 (GND), U1.43 (GND), U1.44 (GND), U1.45 (GND), U1.46 (GND), U1.47 (GND), U1.48 (GND), U1.49 (GND), U1.50 (GND), U1.51 (GND), U1.52 (GND), U1.53 (GND), U2.4 (GND), U2.7 (GAINSEL), U2.9 (GND), U3.2 (NC), U3.3 (PG), U3.5 (GND), U3.7 (EP), U4.5 (RES), U4.6 (GND), U4.7 (GND), U4.8 (GND), U5.2 (GND), U6.2 (GND)
/INT: J2.5, U1.5 (IO2), U4.12 (INT1)
/IO5: C16.1, J6.2, R19.1, R20.1, U1.10 (IO5)
/IO8: J6.5, R11.2, U1.22 (IO8)
/IO15: R22.1, U1.20 (IO15), U6.3 (EN)
/IO20: J6.3, U1.26 (IO20)
/IO21: J6.4, U1.27 (IO21)
/IO23: J7.2, U1.29 (IO23)
/ISEN: R1.1, R8.1, U2.8 (IPROPI)
/ISEN_ADC: C14.1, R8.2, U1.13 (IO1)
/LED: R9.1, U1.19 (IO14)
/LED_A: D1.2 (A), R9.2
/MOT_IN1: U1.24 (IO18), U2.6 (IN1)
/MOT_IN2: U1.25 (IO19), U2.5 (IN2)
/OUT_A: BT1.1, R3.1, R5.1, U2.2 (OUT1)
/OUT_B: BT2.1, R4.1, U2.3 (OUT2)
/RXD: J3.5, U1.30 (RXD0/IO17)
/SCL: J2.4, R10.2, U1.16 (IO7), U4.1 (SCL/SPC)
/SDA: J2.3, R16.2, U1.15 (IO6), U4.4 (SDA/SDI)
/SENSE: R5.2, U1.6 (IO3)
/TXD: J3.2, U1.31 (TXD0/IO16)
/USB_D+: J4.A6 (D+), J4.B6 (D+), U1.18 (IO13/USB_D+), U5.1 (I/O1), U5.6 (I/O1)
/USB_D-: J4.A7 (D-), J4.B7 (D-), U1.17 (IO12/USB_D-), U5.3 (I/O2), U5.4 (I/O2)
/VBAT_ADC: C13.1, R6.2, R7.1, U1.12 (IO0)
/VBUS_DET: R14.2, R15.1, U1.9 (IO4)
/VBUS_J4: D2.2 (A), J4.A4 (VBUS), J4.A9 (VBUS), J4.B4 (VBUS), J4.B9 (VBUS), Q1.1 (G), R14.1, TP2.1, U5.5 (VBUS)
/VLED: C17.1, C18.1, J7.1, R23.1, U6.5 (OUT)
/VLED_ADJ: R23.2, R24.1, U6.4 (ADJ)
/VSYS: C1.1, C2.1, C4.1, C8.1, D2.1 (K), Q1.2 (S), R6.1, TP1.1, U2.1 (VM), U3.4 (EN), U3.6 (IN), U6.1 (IN)

Notes on the sheet:
USB-C (flashing + 5 V operation), ESD protection, VBUS detection
Power path: VBUS via D2, battery/charger board (BAT_IN) via Q1 -> VSYS
3.3 V regulator (LDO) and battery voltage (VSYS)
ESP32-C6
Output stage (DRV8213, current sensing IPROPI, current limit approx. 2 A)
Lever detection (lever closed = SENSE HIGH) and contacts at the board ends
Expansion pads (I2C/INT) and service pads, bottom side
Accelerometer (I2C 0x18, INT1 to IO2), population optional
Bottom, DNP: player pads J6
Bottom, DNP: LED pads J7, U6
Bottom: test points

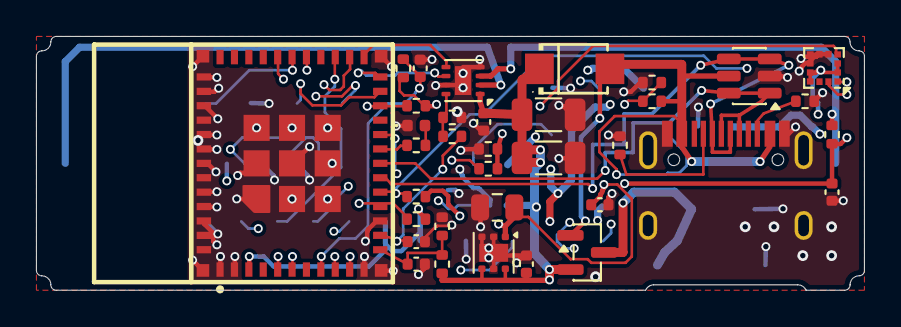
[picture p20: board louie-main.kicad_pcb from above]

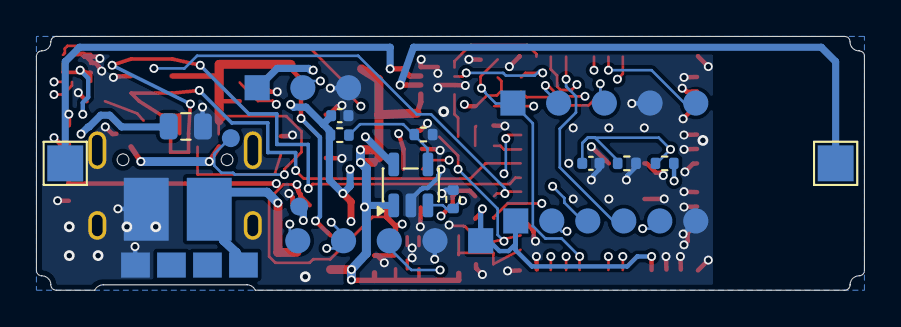
[picture p21: board louie-main.kicad_pcb from below]

Board: 4 copper layers, 46.0 x 14.1 mm, 54 parts (19 on the bottom side), 35 nets.
