ditschi/looping_louie/hardware/charger-board/louie-charger.kicad_pcb

## KiCad design hardware/charger-board/louie-charger.kicad_pcb (2026-11-08)

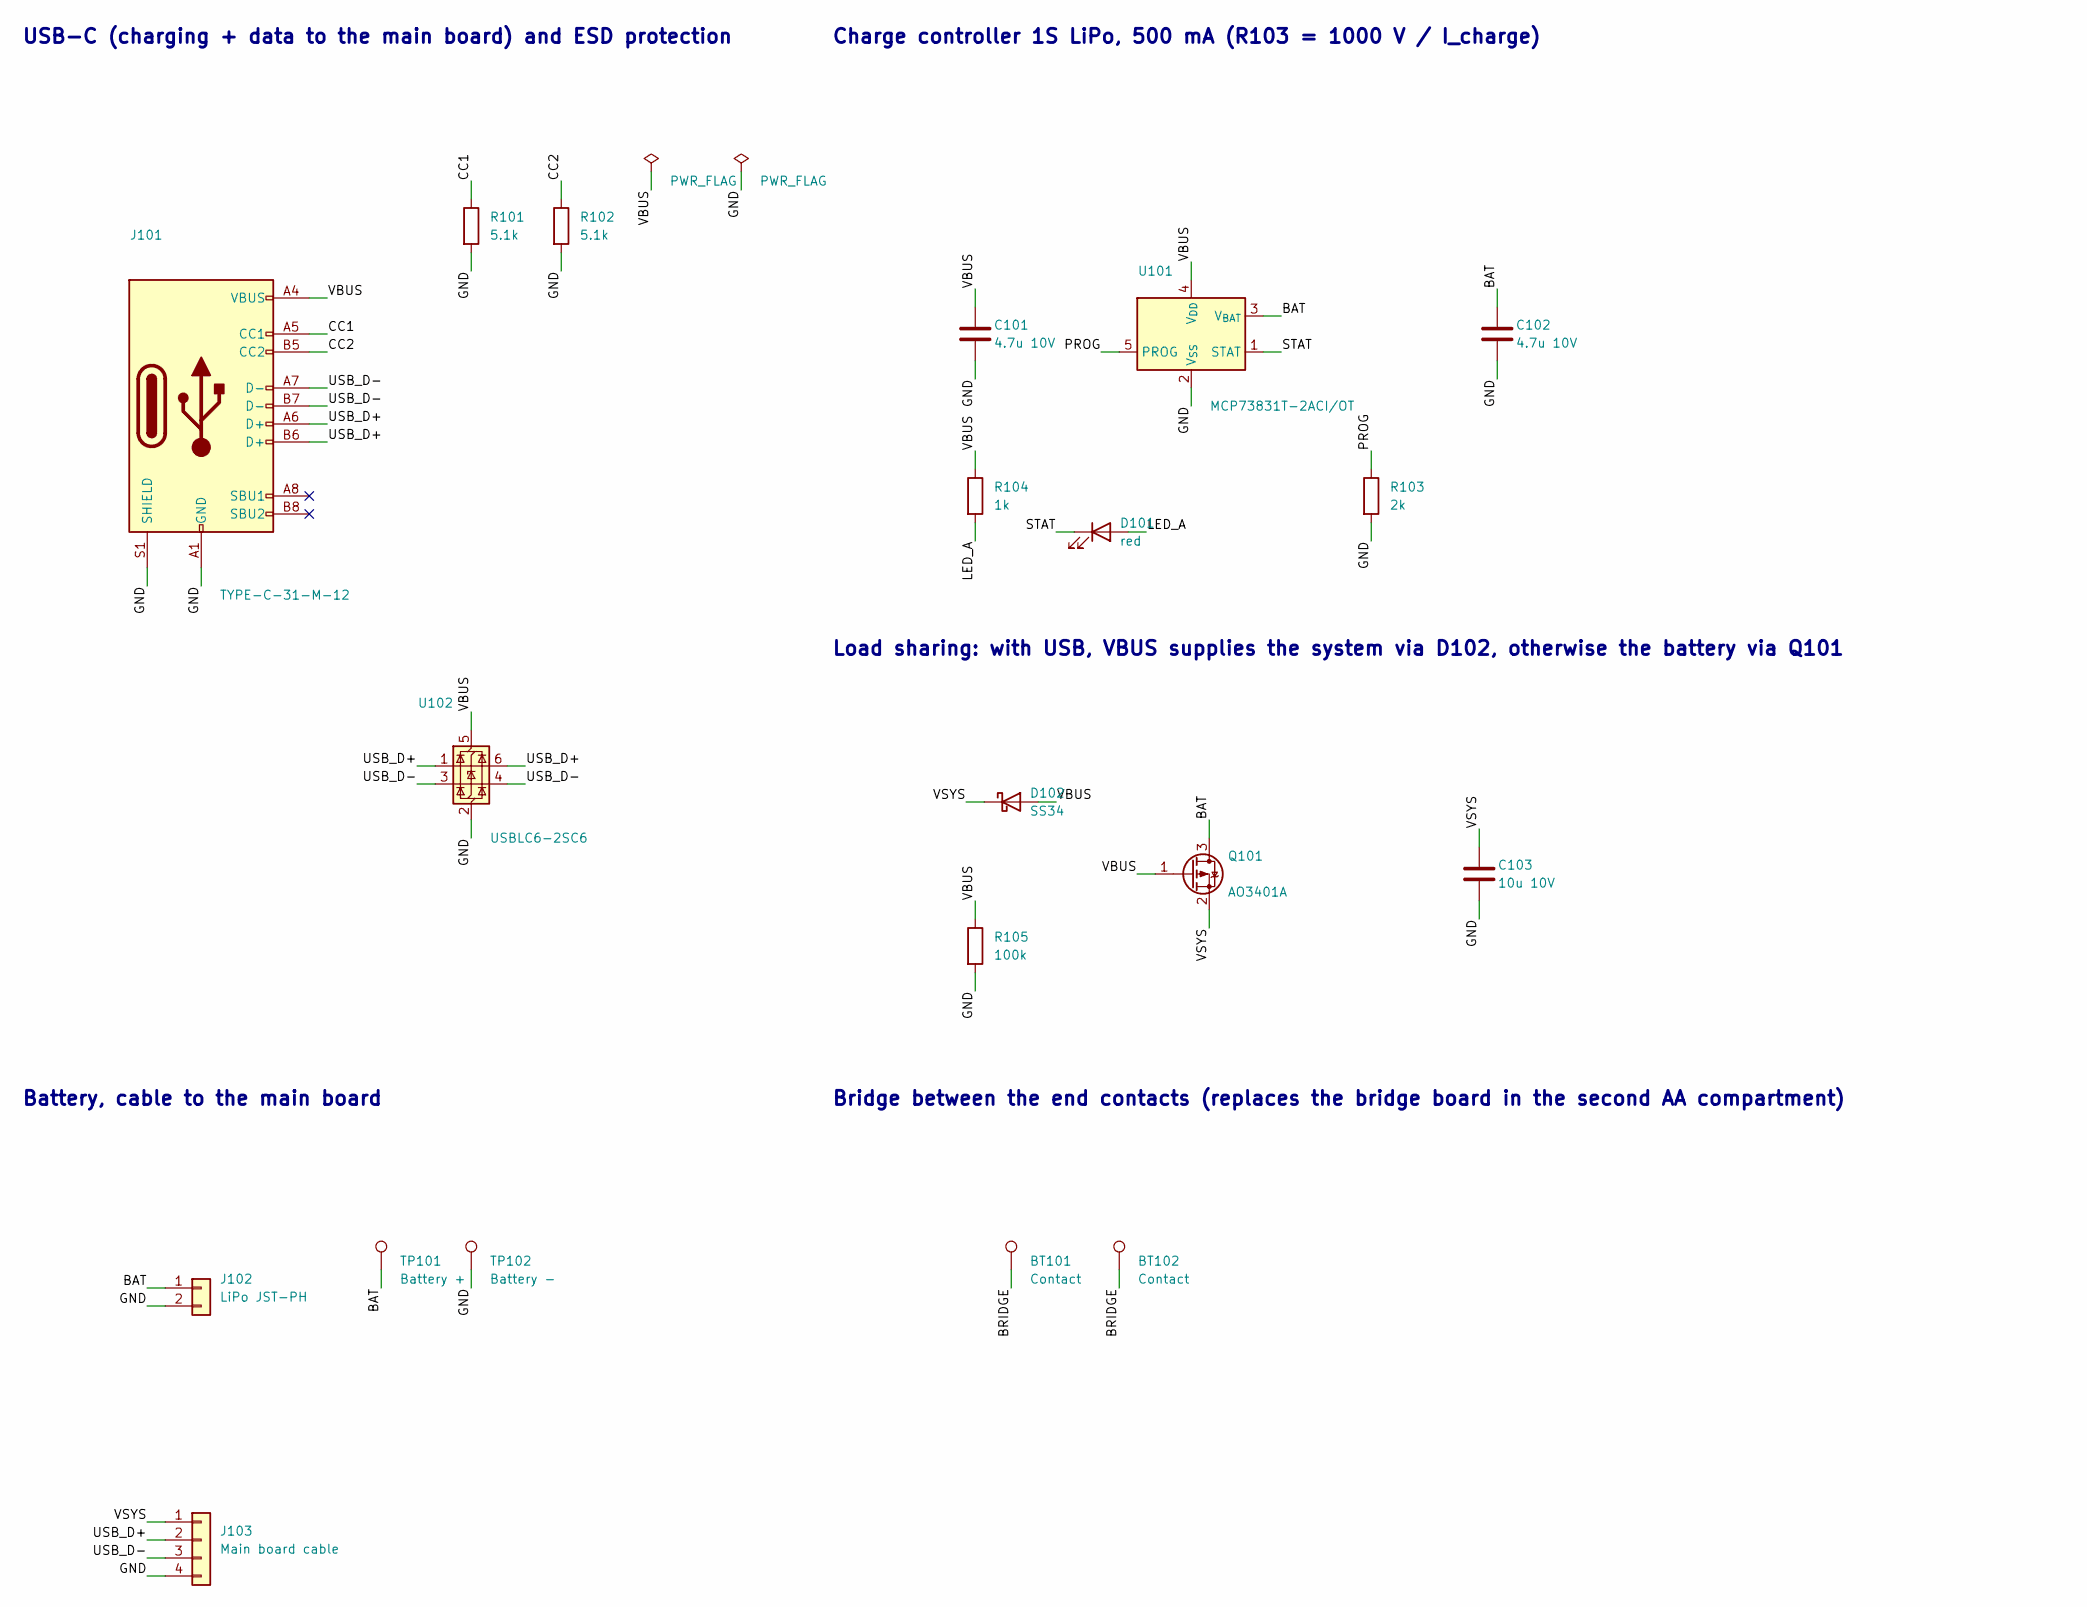
[picture p22: schematic louie-charger.kicad_sch, Looping Louie Wi-Fi upgrade – charger board]

Parts:
BT101, BT102: Contact; TestPoint_Pad_2.0x2.0mm
C101, C102: 4.7u 10V; C_0603_1608Metric
C103: 10u 10V; C_0805_2012Metric
D101: red; LED_0603_1608Metric; LCSC Part C2286
D102: SS34; D_SMA; LCSC Part C8678
J101: TYPE-C-31-M-12; USB_C_Receptacle_HRO_TYPE-C-31-M-12; LCSC Part C165948
J102: LiPo JST-PH; JST_PH_S2B-PH-SM4-TB_1x02-1MP_P2.00mm_Horizontal; LCSC Part C295747
J103: Main board cable; SolderPads_1x04_P2.00mm
Q101: AO3401A; SOT-23; LCSC Part C15127
R101, R102: 5.1k; R_0603_1608Metric
R103: 2k; R_0603_1608Metric
R104: 1k; R_0603_1608Metric
R105: 100k; R_0603_1608Metric
TP101: Battery +; TestPoint_Pad_2.0x2.0mm
TP102: Battery -; TestPoint_Pad_2.0x2.0mm
U101: MCP73831T-2ACI/OT; SOT-23-5; LCSC Part C424093
U102: USBLC6-2SC6; SOT-23-6; LCSC Part C7519

Connections:
/BAT: C102.1, J102.1, Q101.3 (D), TP101.1, U101.3 (V_{BAT})
/BRIDGE: BT101.1, BT102.1
/CC1: J101.A5 (CC1), R101.1
/CC2: J101.B5 (CC2), R102.1
/GND: C101.2, C102.2, C103.2, J101.A1 (GND), J101.A12 (GND), J101.B1 (GND), J101.B12 (GND), J101.S1 (SHIELD), J102.2, J103.4, R101.2, R102.2, R103.2, R105.2, TP102.1, U101.2 (V_{SS}), U102.2 (GND)
/LED_A: D101.2 (A), R104.2
/PROG: R103.1, U101.5 (PROG)
/STAT: D101.1 (K), U101.1 (STAT)
/USB_D+: J101.A6 (D+), J101.B6 (D+), J103.2, U102.1 (I/O1), U102.6 (I/O1)
/USB_D-: J101.A7 (D-), J101.B7 (D-), J103.3, U102.3 (I/O2), U102.4 (I/O2)
/VBUS: C101.1, D102.2 (A), J101.A4 (VBUS), J101.A9 (VBUS), J101.B4 (VBUS), J101.B9 (VBUS), Q101.1 (G), R104.1, R105.1, U101.4 (V_{DD}), U102.5 (VBUS)
/VSYS: C103.1, D102.1 (K), J103.1, Q101.2 (S)

Notes on the sheet:
USB-C (charging + data to the main board) and ESD protection
Charge controller 1S LiPo, 500 mA (R103 = 1000 V / I_charge)
Load sharing: with USB, VBUS supplies the system via D102, otherwise the battery via Q101
Battery, cable to the main board
Bridge between the end contacts (replaces the bridge board in the second AA compartment)

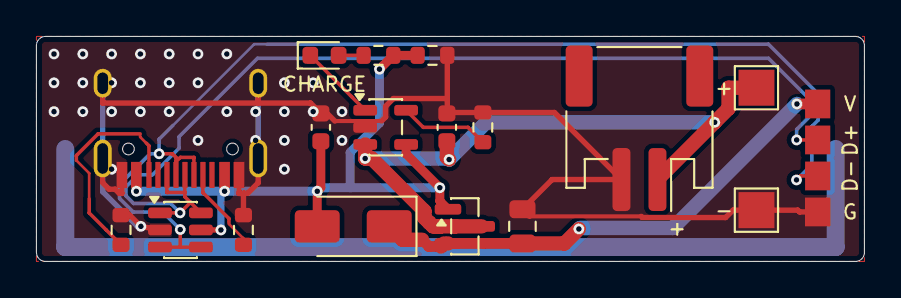
[picture p23: board louie-charger.kicad_pcb from above]

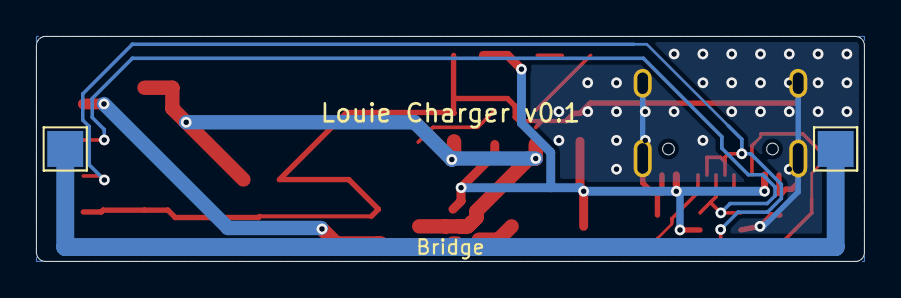
[picture p24: board louie-charger.kicad_pcb from below]

Board: 2 copper layers, 46.0 x 12.5 mm, 20 parts (2 on the bottom side), 12 nets.
