ditschi/looping_louie/(commit log)

2018-09-30 initial main.py allowing to control the onboard LED
2021-10-03 current unstaged work
2021-10-03 wip -- reworked game and hw_control
    [gameplay.py]
2023-02-10 current work before switching to esp32 config
2023-02-10 boot.py now working - hardware/Led.py - hardware/wifi.py
2023-02-13 Timers, LED and morotr abstraction now working
2023-11-07 added Fritzing pcb
    [LoopingLouie-pcb.fzz, LoopingLouie.kicad_sch]
2026-10-31 Neustart v2: Projektgerüst, Konzept, Bauteilbibliothek
    Alter MicroPython/ESP8266-Stand entfernt (erhalten im Tag v1-legacy).
    - docs/hardware-konzept.md: Hauptplatine im AA-Format mit ESP32-C3 und
    DRV8833, Hebel-Erkennung, Bestückungsstrategie, Marktrecherche
    - docs/entwicklung.md, setup.sh: Abhängigkeiten und Einrichtung
    - justfile: ERC, DRC, Renders, Fertigungsdaten über kicad-cli
    - hardware/bom/teile.csv: Stückliste mit LCSC-Nummern und Alternativen
    - hardware/lib: Symbole, Footprints und 3D-Modelle der LCSC-Teile
    - hardware/main-board: KiCad-Projekt mit AA-Umriss (46 x 13,5 mm)
    [LoopingLouie-pcb.fzz, LoopingLouie.kicad_sch, louie-main.kicad_pcb, louie-main.kicad_sch, teile.csv]
2026-10-31 Schaltplan der Hauptplatine (erzeugt, ERC fehlerfrei)
    - gen_main_schematic.py: Schaltung als Python-Beschreibung, erzeugt den
    Schaltplan mit Netz-Labels; ESP32-C3, DRV8833 (parallel, Shunt 0,1 Ohm),
    AP2112K, Hebel-Erkennung, Akkuspannung, Testpads, Kabel zur Ladeplatine
    - gen_symbols.py: eigene Symbole ESP32-C3-MINI-1 und DRV8833PWP_parallel
    mit korrekten Pin-Typen
    - DRV8833, AP2112K, JST-SH aus KiCads Standardbibliothek statt LCSC
    - Pinbelegung im Konzept aktualisiert, neue offene Punkte
    [louie-main.kicad_sch, teile.csv]
2026-10-31 Probeplatzierung Hauptplatine: einseitig passt nicht, Variante 2 passt
    - gen_main_pcb.py: Schaltplan per Skript auf die Platine, Designregeln,
    Netzklasse Power, Antennen-Sperrflächen, Thermal-Vias, Masseflächen
    - placement_einseitig.py: Machbarkeitstest (dicht gepackt, 12 Teile passen nicht)
    - placement_zweiseitig.py: oben Maschine, unten Handlöten (0603), DRC-sauber
    - plot_layout.py: Platzierungsbild mit Luftlinien und Überlappungsprüfung
    - route.py + setup.sh: Freerouting-Anbindung über Specctra DSN/SES
    - Testpads nicht in der Stückliste, DRV8833-Footprint ohne 0,2-mm-Vias
    - docs/offene-punkte.md: offene Fragen, Annahmen, Alternativen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
    [louie-main.kicad_pcb, louie-main.kicad_sch]
2026-10-31 Kostenabschätzung (JLCPCB, PCBWay, Aisler) und Hinweis ESP32-C3-MINI-1-N4X
    [teile.csv]
2026-10-31 Ideen I1 (USB-C-Akku-AA-Zellen) und I2 (USB-C-Buchse auf der Hauptplatine) notiert
2026-11-01 Hauptplatine Variante 1b: einseitig, 0402, ca. 95 % geroutet
    - Schaltplan: Passive in 0402, Lötpads statt JST-Stecker, neutrale Netznamen
    (OUT_A/OUT_B, DRV_*), Testpads für freie GPIOs IO2/IO8
    - Platzierung einseitig: eine 0402-Reihe am Modul, DRV8833 um 90° gedreht
    - Vorrouting per Skript: DRV-Ausgangsseite (OUT_A/OUT_B/ISEN), VSYS-
    Sammelschiene, Bahn zum Endkontakt neben der Antenne, GND-Vias im Modul
    - route.py: Freerouting ohne Kupferflächen und ohne GND, mehrere Versuche,
    bestes Ergebnis; stitch.py: GND-Stitching für Pads, Raster und Inseln
    - Rest (3 Signale, GND-Inseln) für Handarbeit im GUI dokumentiert
    - docs: offene Punkte/Annahmen aktualisiert, Recherche optionale Hard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
    [louie-main.kicad_pcb, louie-main.kicad_sch, teile.csv]
2026-11-01 Layout: Antennen-Ende frei von Fläche/Vias, feste GND-Vias für Shunt und C12; Rest 3 Messleitungen
    [louie-main.kicad_pcb]
2026-11-01 Beschleunigungssensor LIS2DH12, I2C-Erweiterungs- und Taster-Pads
    - LIS2DH12 (eigenes Symbol, LGA-12) oben bestückt, I2C an IO2/IO8 (0x18),
    INT1 an RXD, 100 nF Abblockung
    - Testpads ersetzt durch zwei Lötpad-Reihen im 2,54-mm-Raster:
    J2 Erweiterung (3V3 GND SDA SCL INT), J3 Service (EN TXD BOOT GND, Taster)
    - feste Vorverbindungen ISEN->R8, R5/OUT_A per Via, GND-Vias für C10/C12/C15
    - Stitching: Sperrflächen-Prüfung mit Via-Radius
    - Doku: Pinbelegung, Annahmen A18/A19, Stand Routing
    [louie-main.kicad_pcb, louie-main.kicad_sch, teile.csv]
2026-11-01 Aktuelle Bilder, 3D-Modell-Export und Mechanik (Hülle)
    - just images: alle Bilder der Hauptplatine nach docs/bilder/ (3D oben/unten,
    Draufsichten, Kupferlagen, Schaltplan, Platzierung)
    - just render: zusätzlich schräge Ansicht von unten
    - just modell: STEP, GLB und STL der Platine nach build/main-board/3d/
    - hardware/mechanik: OpenSCAD-Hülle (AA-Schale, Kappen, C-Hülse), just stl,
    Konzept Kapitel 6 ergänzt
    [huelle.scad]
2026-11-02 Web-UI-Konzept mit Prototyp, Funk-/Controller-Analysen und Ladeplatine
    Web-UI (Agenten-Team: Analyse, Konzept, Bau, Persona-Tests):
    - docs/web-ui-konzept.md: Rollen (Steuern/Mitspielen/Besitzer), Spielleiter-
    Übergabe, Mitspieler-Handys, Ansichten je Phase ohne Scrollen, Werkstatt
    - docs/modus-baukasten.md: Spielmodi in vier Schichten, Joker, Fiesheit, Editor
    - docs/geraete-anlernen.md: Spieler als Platz mit Handy und/oder Funk-Tastern
    - web/poc/: klickbarer Prototyp mit simuliertem Server, mehreren Handys,
    Modus-Baukasten und simulierten BTHome-Tastern
    Analysen:
    - idee-funk-taster.md (BTHome-Taster für V1), firmware-sprache.md,
    analyse-funk-controller.md (Antenne, Layout, ESP32-C6)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
    [ladeplatine.scad, louie-charger.kicad_pcb, louie-charger.kicad_sch, teile.csv]
2026-11-02 Hauptplatine auf ESP32-C6, DRV8213 und USB-C umgebaut (2 Lagen, 13 offen)
    - Wechsel ESP32-C3 → ESP32-C6-MINI-1 (C3 verworfen), neue Pinbelegung
    - DRV8213 mit IPROPI statt DRV8833 + Shunt
    - USB-C-Buchse auf der Platine (Variante E) mit ESD (USBLC6 durchgeführt nach
    Datenblatt), CC, Power-Path, VBUS-Erkennung; Flashen über Ladeplatine entfällt
    - LIS2DH12 bleibt oben (bestückungsoptional), I²C-Pads für Erweiterungen
    - SENSE-Pegel umgedreht (Wecken auf High), Antennen-Keepout ohne GND-Streifen
    - Fertigungsregeln mit Quelle (JLCPCB 2 Lagen): 0,13 mm Abstand/Mindestbahn
    - Routing: ERC/DRC 0, aber 13 offene Verbindungen → 4-Lagen-Analyse folgt
    - Doku: hauptplatine-c6.md, idee-zigbee-bet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
    [huelle.scad, louie-main.kicad_pcb, louie-main.kicad_sch, teile.csv]
2026-11-03 Make the 4-layer main board the standard and add a keep-best routing gate
    - Main board is now 4 layers (JLC04081H-3313, 0.8 mm, L2 solid GND): ERC 0,
    DRC 0, 0 unconnected; 2-layer variant discarded (13 open, see c45c6de)
    - route_fix.py: own maze router used for the main board (Freerouting left
    10-18 open on 4 layers); charger board keeps Freerouting
    - route_gate.py + routing.json: a new routing run only replaces the official
    board if it is better for the same design fingerprint; rejected runs go to
    build/<board>/route/rejected/, force and runs options, route-baseline recipe
    - placement_einseitig.py renamed to placement.py, double-sided C3 placement
    removed; justfile defaults to the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
    [louie-main.kicad_pcb]
2026-11-04 Add routing score proposal and optional hardware analysis for C6
    - docs/routing-score.md: hard constraints plus weighted score for routing
    quality, default weights, prototype results (official 4-layer board wins,
    found too narrow VSYS path to the motor driver)
    - docs/idee-optionale-hardware.md: re-evaluation for ESP32-C6 and 4 layers;
    NeoPixel port with switchable supply, four cable buttons, reed contact
    instead of piezo, full GPIO plan
2026-11-06 Switch firmware plan to Rust, clean up and translate docs, add license
    - Firmware: Rust (std on ESP-IDF) replaces MicroPython; new
    firmware-architecture.md (crates, HAL, board definitions, motor safety,
    WebSocket send path, RAM/flash budget), revised after a critical review
    - Docs: remove superseded content (ESP32-C3, DRV8833, 2 layers,
    MicroPython); rejected options summarized in decision-history.md
    - New test-hardware.md: breadboard pre-order checks (motor, lever network,
    strapping/wake, IO18/IO19 reset level, ADC dividers), LED-mode software
    setup, prototype order and reorder costs
    - Translate doc contents to English (file names unchanged for now;
    hauptplatine-c6.md and routin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
2026-11-07 Add routing score, expansion pads and 14.1 mm board width (routing incomplete)
    - route_score.py + routing-score.toml: hard constraints, Deb rule and
    weighted score (approved weights) replace the lexicographic gate ranking;
    just score / just explain
    - Motor supply path Q1 -> VM prerouted at 0.5 mm on outer layers; power nets
    never routed below required width; stale net classes removed
    - Optional bottom-side pads (DNP): J6 player inputs (IO5/20/21/8), J7 NeoPixel
    port with TPS22918 load switch, PTC, 0603 bridge, full service header J3,
    TP1/TP2; load pulse and J6 RC footprints dropped; DNP parts excluded from
    assembly files
    - Board widened to 14.1 mm with 12.5 mm end tongues and J4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
    [huelle.scad, louie-main.kicad_pcb, louie-main.kicad_sch, teile.csv]
2026-11-08 Translate repo to English, add firmware step 0 and sleeve renders
    - Rename German docs, images, mechanics and BOM files to English names
    (docs/images/, hardware/mechanics/sleeve.scad + charger-holder.scad,
    bom/parts.csv) and update all references
    - Translate remaining docs, script comments/messages, SCAD identifiers,
    justfile, setup.sh, BOM columns and KiCad text strings (values, notes,
    silkscreen, zone names, net BRUECKE -> BRIDGE); geometry unchanged,
    ERC/DRC identical; antenna zones renamed with legacy prefix fallback
    - Rename recipe just modell -> just model, fab outputs -bom/-cpl/-schematic
    - Sleeve: board_stl option renders the real KiCad board in the views,
    dummy updated (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
    [charger-holder.scad, huelle.scad, ladeplatine.scad, louie-charger.kicad_pcb, louie-charger.kicad_sch, louie-main.kicad_pcb, louie-main.kicad_sch, parts.csv]
2026-11-09 Add datasheet and wiring review for main and charger board
    - docs/datasheets.md: index of the datasheets (manufacturer, revision, URL);
    PDFs stay out of git (datasheets/ in .gitignore), `just datasheets` fetches them
    - docs/datasheet-facts.md: extracted facts, each item verified against the PDFs
    - docs/wiring-review.md: datasheet vs. symbol vs. footprint vs. PCB nets, ratings,
    polarity, required parts; no errors, warnings W1-W17, delta for VSYS 6.6 V (SPX3819)
    - docs/open-items.md: new decisions F19-F27, A18 polarity answered, A3/A11 updated
2026-11-09 Fix module bottleneck and support 4 x AA supply on the main board
    Bottleneck at the right module pins (docs/main-board-c6.md 11.9):
    - Move the VBAT divider R6/R7 next to C13 and the EN parts R2/C12 to
    the top right module corner.
    - Replace preroute_vbat_escape() with preroute_adc_stubs() for the
    short ADC connections. Variant tests went from 5-9 to 0-2 unrouted
    connections per attempt.
    - route_fix: add FANOUT_MODULE_CLEAR (off by default) and HOLE_TO_HOLE.
    Supply VSYS 3.0-6.6 V for 4 x AA (docs/main-board-c6.md 2.7, F18):
    - LDO SPX3819-3.3 instead of AP2112K (pin-compatible).
    - Divider 680k/470k, 16 V buffer capacitors.
    - LED option: adjustable SPX3819 at 3.95 V with C18/R23/R24 inste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
    [louie-main.kicad_pcb, louie-main.kicad_sch, parts.csv]
2026-11-09 Update review status after the 4 x AA power path changes
    F19, F21 (SA0), F24 and F27 updated to the decisions in 8ce96f0; F26 merged into F28; A3 now SPX3819.
2026-11-10 Fix LED LDO routing and document accepted review findings
    - preroute_led_ldo(): lock U6 VIN to the battery VSYS track on the bottom.
    - Move R22 next to the EN pin of U6.
    Routing test: 1.0 instead of 1.7 unrouted per attempt on average, and
    VSYS and IO15 no longer stay open.
    - Document why C12/EN distance, the missing 3V3 capacitor at module pad 3,
    C15 distance and the missing IO9 pull-up are accepted for this revision
    (a DNP capacitor under pad 3 made routing worse). Add prototype checks
    for 3V3 at the module during Wi-Fi TX and for reset/boot.
    [louie-main.kicad_pcb]
2026-11-10 Fix prototype check text: C19 footprint was dropped
2026-11-10 Route the main board completely (0 unrouted, 0 DRC errors)
    Long run with 120 attempts (pre=none,krt,krt-novip): 19 attempts complete
    without hard violations, 22 with 0 open connections. The gate accepted
    attempt 39 (own router, via cost 30, seed 2, pre-router krt-novip):
    157 vias, 808 mm, score S 100.18. The previous design had 12 unrouted
    connections and 11 GND islands. One DRC warning remains: a dangling
    0.07 mm 3V3 stub.
    [louie-main.kicad_pcb]
2026-11-10 Remove dangling 3V3 stub and re-record the routing baseline
    DRC now has 0 errors, 0 warnings and 0 unrouted connections; score S 97.97.
    [louie-main.kicad_pcb]
2026-11-11 Rev B trial: TPS62162 buck converter instead of the 3.3 V LDO
    Replace U3 SPX3819 (SOT-23-5) by the synchronous buck TPS62162DSGR
    (WSON-8 2x2, same DSG package as the DRV8213) with L1 2.2 uH (Murata
    DFE201612P, 2016), C8 10 uF and C9 22 uF 0805; C11 dropped. Supply range
    stays 3.0-6.6 V, the regulator now dissipates about 50 mW instead of
    0.5 W at 6.4 V and the standby current drops from about 100 uA to 25 uA
    (docs/proposal-supply-buck.md, review finding R-B1).
    Generators: own symbol TPS62162DSG, schematic block with PWR_FLAG on
    3V3, placement of the block at the +y edge (U3 rotated 90 deg, one EP
    via in the J2 gap, Q1 0.1 mm towards the edge), locked pre-routes for
    VIN/EN, SW, VOS and the o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
    [louie-main.kicad_pcb, louie-main.kicad_sch, parts.csv]
2026-11-11 Document the rev B supply decision (buck converter instead of the LDO)
    The owner decided on 2026-11-11 that rev B with the TPS62162 buck converter
    is the design to order; rev A with the SPX3819 LDO stays on main as fallback.
    - main-board-c6.md 2.7 is now the single supply table (VSYS range, U3/L1,
    C8/C9, dissipation, standby, cut-off thresholds per R-B2, divider) with
    switch-node layout notes; status, summary, 5.1, chapter 7 and the routing
    result in 11.4 (rev B baseline 53263dc0ea vs. rev A) updated.
    - hardware-concept.md 5.x: stale AP2112K, 470k/470k, 3.0-5.5 V and TPS22918
    text removed (R-I1), U3/L1 rows, references to 2.7.
    - open-items.md: F15, F18, F24, F27, A3, A5 rewritten, n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
2026-11-11 Add the datasheet delta review of the rev B buck block
    The first pass of the review had been written in the main checkout
    (uncommitted, against the proposal sketch and the rev A board). It is
    redone here against the implemented rev B (pad nets, positions and
    clearances read from the routed board) and checked again against TI
    SLVSAM2E Rev. E and the Murata DFE201612P specification.
    wiring-review.md section 8: pinout, voltages, LC filter, inductor
    current, U3 land pattern, tented EP via and the copper-under-coil rule
    are correct. Findings: W18 L1 footprint smaller than Murata's land
    pattern, W19 C8 far from VIN and only 10 V 0402, W20 VOS taken at L1
    instead of C9 (note), W21 no power-save mo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
2026-11-11 Add the options analysis for low standby with a Li-ion cell (W21)
    The TPS6216x does not enter power-save mode below about 3.8 V input, so a
    Li-ion cell would see mA standby. proposal-supply-standby.md compares the
    options against the datasheets (TPS7A26 SBVS290B, TPS6284x SLVSEC6D and
    the rejected TPS629210, TPS62902, TPS6213x, TPS62125, TPS6217x, TPS7A25,
    TPS63802) and live JLC stock: A low-Iq LDO TPS7A2633 in WSON-6
    (recommended), B buck TPS62840 (6.5 V limit), C hybrid buck + LDO.
    Linked from F29, W21, main-board-c6.md 2.7 and the README.
2026-11-11 Rev B: low-Iq LDO TPS7A2633 instead of the TPS62162 buck (option A)
    The buck did not enter power-save mode below about 3.8 V input (wiring
    review W21), so a Li-ion cell would have seen mA standby. Option A of
    docs/proposal-supply-standby.md: U3 = TPS7A2633DRVR (2.4-18 V, 500 mA,
    IQ 2 uA, WSON-6 2x2), board standby about 15-18 uA over 3.0-6.6 V.
    Generators: own symbol TPS7A26DRV; U3 rotated 270 deg at the +y edge with
    EN/IN into the VSYS edge track (now running on to R6), C8 4.7 uF 16 V at
    IN, C9 22 uF 0805 under OUT; L1, net SW3V3 and its net class removed; two
    tented thermal vias in the EP; locked 3V3 trunk (via, In2, via, B.Cu to
    J2 pad 1), because the first run routed the module side of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
    [louie-main.kicad_pcb, louie-main.kicad_sch, parts.csv]
2026-11-11 Document the mode catalog and the separately updatable UI package
    Decision of 2026-11-09 (written in an earlier session, committed now):
    the core plays one JSON program and keeps a catalog of all modes
    (firmware fallback, UI package, own modes in LittleFS); modes are
    selected by reference with a hash, current.json allows offline
    selection; the UI package has a manifest, is embedded in V1 and can be
    updated separately via www later (E18). firmware-architecture.md 6.4
    holds the details; decision-history, mode-builder, software-concept and
    web-ui-concept reference it.
2026-11-11 Check the 3V3 path in the routing score; rev A becomes a Git tag
    route_score.py: optional max_drop_mv per current path; a larger drop at
    peak_a counts as power_width_violations (hard). routing-score.toml: new
    path "3V3 U3 -> U1 3V3" (0.15 A continuous, 0.38 A peak, 50 mV limit).
    Current board: 38 mOhm, 14.6 mV; the earlier detour state (75 mV) is
    now rejected by the gate. Baseline re-recorded (board unchanged).
    Rev B replaces rev A on main; rev A stays available as the annotated tag
    rev-a-spx3819 (93cbe9c). Documents refer to the tag instead of "rev A
    stays on main"; decision history records the step.
    [route_score.py]
